jluehr-4711/tmp_crane/material/p3.jpeg

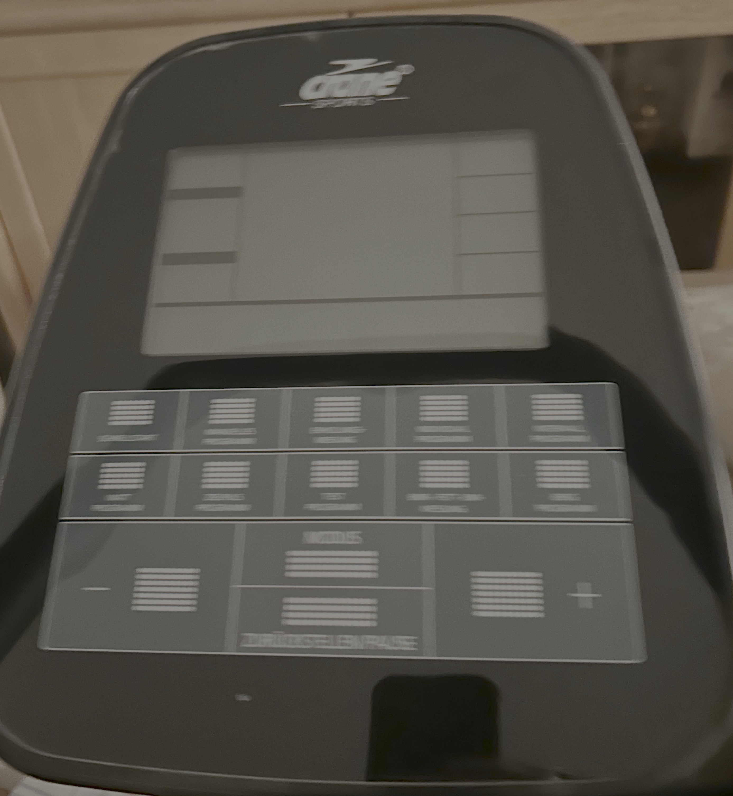
material/p3.jpeg
