jluehr-4711/tmp_crane/material/IMG_0629.jpeg

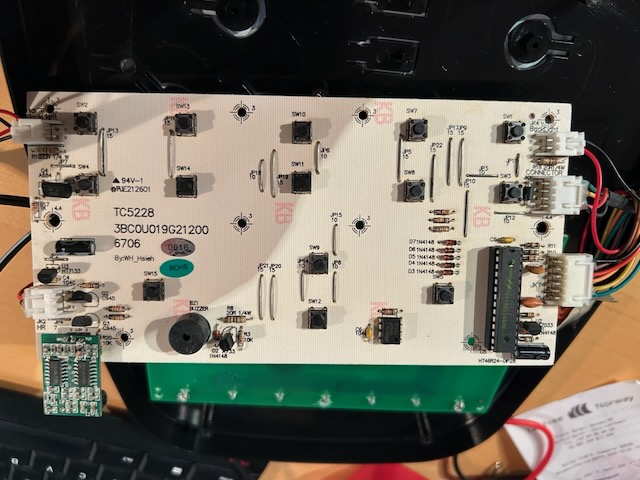
material/IMG_0629.jpeg
