jluehr-4711/tmp_crane/README.md

# tmp_crane

**Temporary data. Do not use.**

This repository is a temporary snapshot and may be changed or deleted at any time.
