jluehr-4711/tmp_crane/docs/README.md

# Project documentation index

Project: control a **Crane Sports Power X6 Crosstrainer-Ergometer** (Royalbeach Art.-Nr. 33821,
Aldi Süd 2006) with an ESP32, while keeping the original console swappable.

| Doc | Purpose |
|-----|---|
| [01-project-overview.md](01-project-overview.md) | Goal, rules, big picture, phases |
| [02-material-inventory.md](02-material-inventory.md) | Every file in `material/` and what it tells us |
| [03-hardware-reference.md](03-hardware-reference.md) | The machine: electrical system, parts, boards, connectors, known/unknown |
| [04-plan.md](04-plan.md) | Phased plan (wiring first, then software), next concrete steps |
| [05-open-questions.md](05-open-questions.md) | Questions for the owner + unknowns to measure |
| [06-photo-guide.md](06-photo-guide.md) | What to photograph before the measurement session, with plain-language locations |
| [07-sniffer.md](07-sniffer.md) | Sniffer firmware: pin map, dividers, parts list, usage |
| [08-prior-art.md](08-prior-art.md) | Existing projects (Reebok 5.7e etc.), what we reuse, what we must still measure |
| [09-shopping-list.md](09-shopping-list.md) | Parts with Reichelt article numbers and Amazon listings |
| [sessions/](sessions/) | One log per session, newest last |
| [reference/](reference/) | Extracted manual text (greppable) |
| [img/](img/) | Crops, rendered manual pages, and `adapter-schematic.svg` (KiCad schematic export) |
| [../hardware/kicad/](../hardware/kicad/) | KiCad schematic of the adapter board + generator script |
| [../hardware/perfboard/](../hardware/perfboard/) | Perfboard layout (validated against the schematic) + link table |
| [../firmware/](../firmware/) | ESP-IDF projects (sniffer) |

## Conventions

- Every session gets `sessions/YYYY-MM-DD-session-NN.md`: what was done, what was found, what is next.
- Measurements go into `03-hardware-reference.md` (facts) and the session log (how obtained).
- Part numbers in parentheses, e.g. "(91)", refer to the manual's spare-parts list (page 19).
- Unverified statements are marked **[assumption]**. Remove the tag once measured.
- Language: English, with original German terms in quotes where they help find things in the manual.
