jluehr-4711/tmp_crane/docs/sessions/2026-10-26-session-02.md

# Session 02 – 2026-10-26 – Repository, CLAUDE.md, sniffer firmware

## Plan step served
Phase 0 close-out (git, CLAUDE.md) and session 2 of the session plan (sniffer firmware, parts list).

## Done
- `git init`, first commit with docs and material. `.gitignore` for ESP-IDF build output.
- CLAUDE.md rewritten: typos fixed, decisions (interface point, ESP32 classic, AM33D, ESP-IDF, FTMS,
  plug swap, level + computed watts, English) recorded, docs pointers kept.
- ESP-IDF v5.5.6 installed under `~/esp/esp-idf`, toolchain under `~/.espressif`. The system has no
  `python3-venv`; the venv was created with `uv` and the requirements installed into it manually.
- `firmware/sniffer/`: ESP-IDF project, builds clean for the classic ESP32 (260 KB image).
  Modules: ADC probes (4 channels, calibrated), MCPWM capture of DOUT (80 MHz timestamps, frequency,
  duty, min/max), speed pulse timing (GPIO interrupt, 5 ms debounce), UART sniff, LEDC PWM output for
  the replay test, serial console with commands.
- `docs/07-sniffer.md`: pin map, dividers, probe harness and parts list, report format, session 4 procedure.

## Prior-art check (owner's question)
No documentation for this board/console exists online. dbsqp/bluetooth-reebok-57e is the closest analog
(5 V 1 kHz PWM brake, reed cadence, empirical watt model, ESP32 FTMS) and confirms the architecture; see
`08-prior-art.md`.

## Not done / limits
- The firmware is compiled but **not yet run on hardware**; a bench test with a known PWM (e.g. the
  ESP32's own GPIO27 output looped to GPIO25) is the first thing to do in session 3.

## Next
- Owner: order the parts in `07-sniffer.md`, flash the sniffer, loop GPIO27 → GPIO25 and check that
  `pwm 1000 25` is reported as 1000 Hz / 25 %.
- Session 3 at the machine: photos and multimeter identification (ground/speed wire), see `06-photo-guide.md`.
