jluehr-4711/tmp_crane/docs/img/adapter-perfboard.png

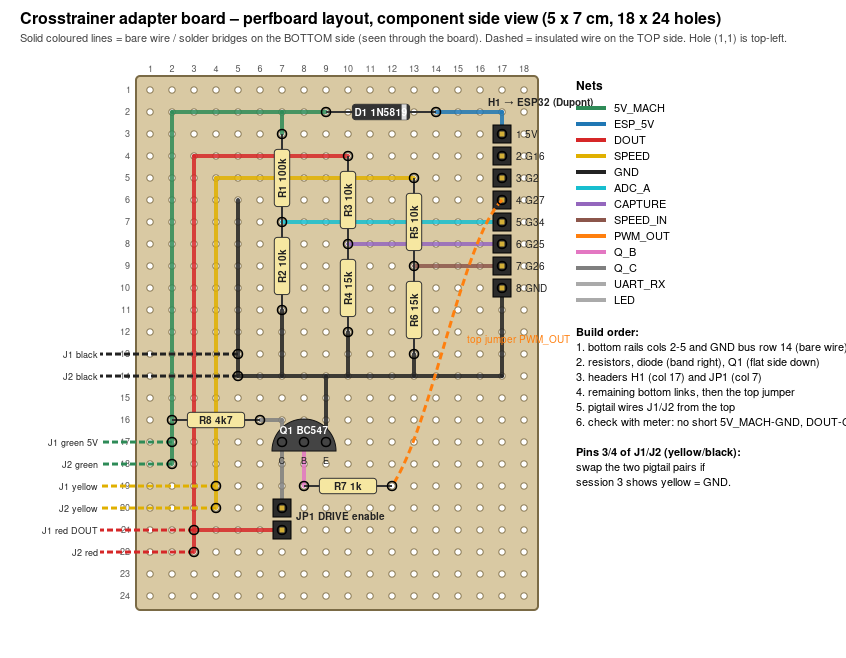
docs/img/adapter-perfboard.png
