jluehr-4711/tmp_crane/docs/img/adapter-schematic.png

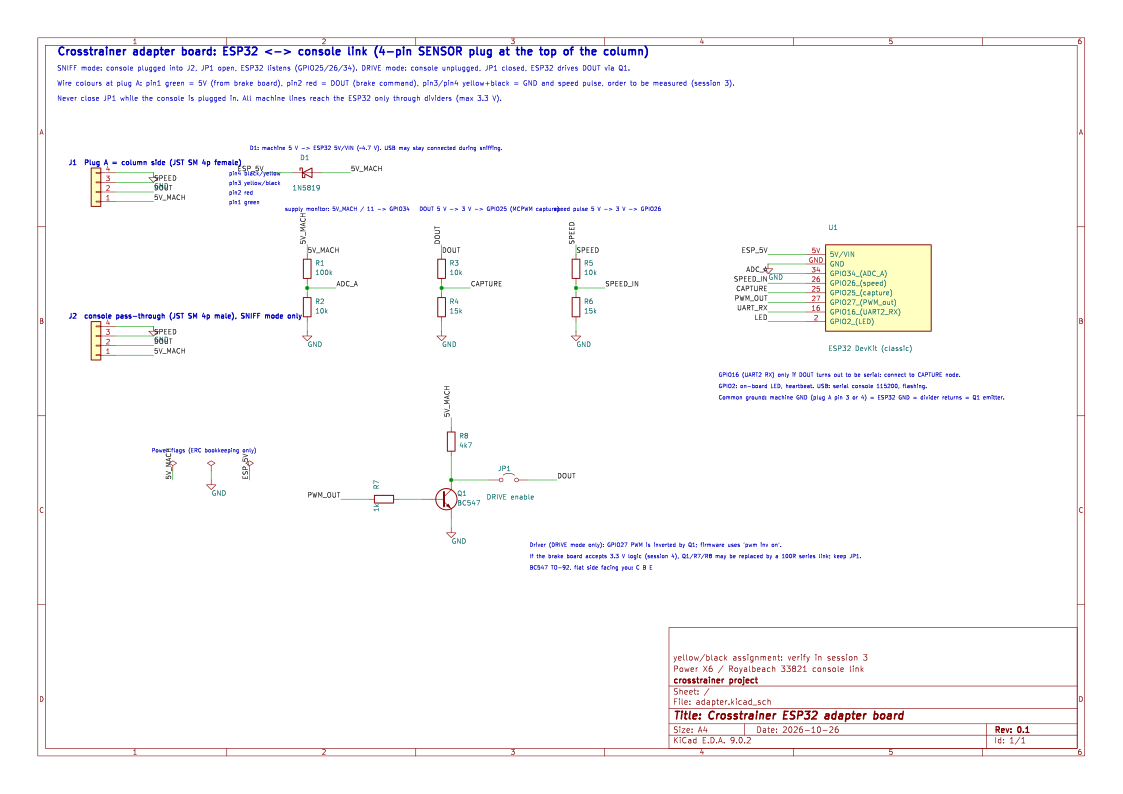
docs/img/adapter-schematic.png
