jluehr-4711/tmp_crane/docs/img/console-mainboard-label.png

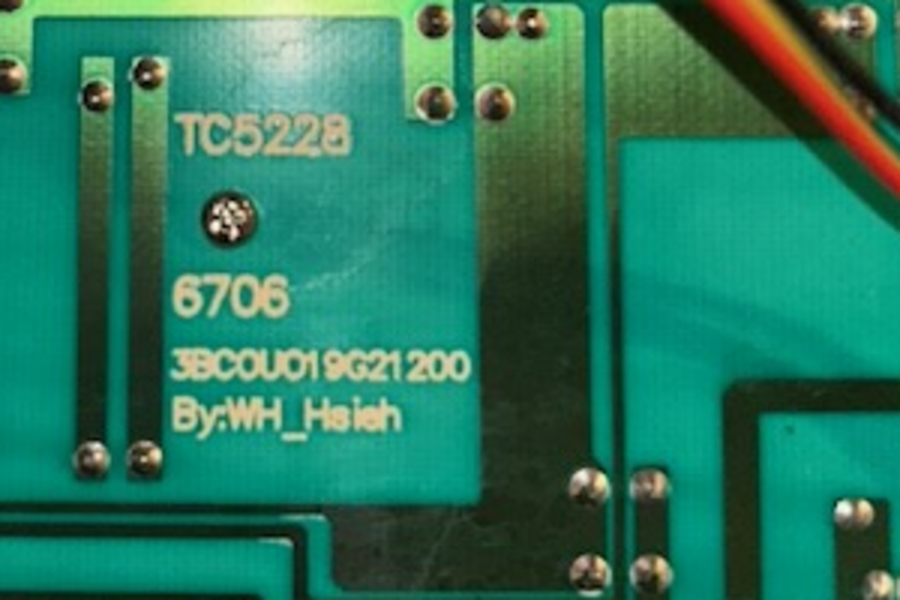
docs/img/console-mainboard-label.png
