jluehr-4711/tmp_crane/docs/img/console-pulse-daughterboard.png

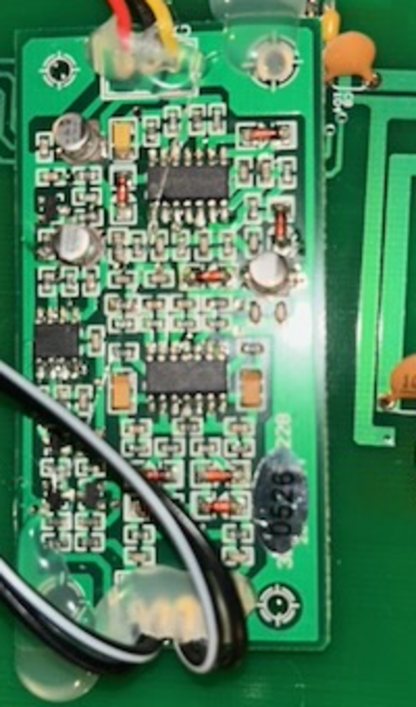
docs/img/console-pulse-daughterboard.png
