jluehr-4711/tmp_crane/docs/02-material-inventory.md

# 02 Material inventory (`material/`)

Reviewed 2026-10-26. Ten files, nine distinct (one duplicate). IMG_0629/0630 added later the same day from /tmp/r2.

| File | Type | What it is | Key facts extracted |
|---|---|---|---|
| `libble-eu_261836.pdf` | PDF, 20 pages A4 landscape, scanned/printed manual "ROY_AldS_BDA_PowerX6_Mont" dated 28.09.2006 | Assembly, operating and training manual for **Power X6 Crosstrainer-Ergometer, Art.-Nr. 33821** (Royalbeach for Aldi Süd) | Features, assembly incl. cable routing, power supply, troubleshooting, watt-measurement procedure, exploded view (p.18), spare-parts list (p.19). Text extracted to `reference/manual-33821-text.txt`. Note: the separate **console manual ("Bedienungsanleitung Computer")** mentioned in the scope of delivery is NOT included. |
| `IMG_0617.jpeg` | Photo 640x480, iPhone, 2026-10-26 18:23 | Label of the wall adapter (104) | **AC-AC ADAPTOR**, brand Yunyong / royalbeach, Model **AYY66-2602500**, Input 230 V~ 50 Hz 350 mA, **Output 26 V~ 2500 mA**, class II, thermal fuse 130 °C, CE/GS. |
| `IMG_0619.jpeg` | Photo 480x640, 2026-10-26 19:35 | Console opened: solder side of the console main PCB, with the small daughterboard at the top edge | Main PCB markings: **TC5228**, **6706**, "3BC0U019G21200 By:WH_Hsieh". A 3-wire lead (black / red / yellow) runs from the main PCB to the daughterboard. Daughterboard has an IR-style LED/receiver dome and a black twisted pair. |
| `IMG_0621.jpeg` | Photo 480x640, 2026-10-26 19:36 | Console opened: component side of the small daughterboard, mounted on the main PCB | Daughterboard marked **0526**; two SOIC-14/16 ICs, one SOT-23 transistor, electrolytics, many 0805 parts. Inputs: two black 2-wire cables (the hand-pulse sensor leads) and the 3-wire red/yellow/black lead to the main board. This is the **hand-pulse amplifier** **[assumption]**, which we do not need. A 100 nF ("104") cap and an SMD part sit next to it on the main board. |
| `p1.jpg` | Photo 1804x1212 | Type label on the console housing | **RB-33821-06605-B**, CE, WEEE symbol, ABS housing. "RB" = Royalbeach, 33821 = article. |
| `p2.jpg` | Photo 2417x1929 | Cable ends at the console / column | Two 2-pin latching connectors (JST SM style) labelled **"PULS"** (hand pulse, 2x), and one larger multi-pin connector labelled **"SEN…"** (cut off; most likely "SENSOR") with at least red and yellow wires visible. Pin count not readable. |
| `p3.jpeg` | Photo 2774x3013 | Console front, powered off | Crane Sports logo; segmented LCD with a large text field; **10 program keys** in two rows of 5; bottom row: **"–"**, a two-key block labelled **"MODE…"** (upper) and **"ZURÜCK / EINSTELLEN / PAUSE"** (lower, blurry), **"+"**. Matches manual: Schnellstart, manuell, HF-gesteuert, Fitnesstest, Typen-Training, Watt, Intervall, Bergfahrt, BMI/BMR/Körperfett, Erholungspuls. |
| `IMG_0629.jpeg` | Photo 640x480, 2026-10-26 20:12 | **Console main PCB, component side**, board out of the housing | Silkscreen readable: TC5228, 6706, 3BC0U019G21200, By:WH_Hsieh, 94V-1, RoHS. Connectors: **JK2 "HR"** 3-pin (to the pulse daughterboard), **JK5 "Backlight"** 3-pin (left), **JK4 "Backlight"** 3-pin (top right), **"CONNECTOR"** 4-pin (right, the cable to the tube; owner reads labels **"5V"** and **"DOUT"** next to it), **JK7** ~8-pin (lower right, multicolour ribbon to the LCD board). Parts: large DIP MCU = **HT46R24-DP28** (read by owner), 8-pin DIP near SW12 (unreadable, "KD363b?"), U2 **HT7133** (3.3 V LDO regulator) with C4 104, U7 **7033** (HT7033 voltage detector/reset) near the MCU, Q2/Q3 **C945** NPN, D1–D7 1N4148, R8/R9 **20 Ω 1/4 W**, buzzer BZ1, 15 tactile switches SW1–SW15, jumpers JP1–JP22. |
| `IMG_0630.jpeg` | Photo 640x480, 2026-10-26 20:13 | **Console main PCB, solder side, cable entry** | The black 4-wire sheathed cable from the tube ends in the 4-pin "CONNECTOR"; wire order at the connector, top to bottom in the photo: **green, yellow, red, black**. A separate multicolour ribbon (brown, red, orange, yellow, green…) goes into the larger white connector (JK7) and on to the LCD board. |
| `Ohne Titel 2.jpg` | duplicate | Byte-identical to `p3.jpeg` (same MD5) | Can be deleted. |

## What the material does NOT contain (needed later)
- Photos of the **brake control board (91)** inside the main frame and its connectors.
- The full pinout of the 4-pin SENSOR/"CONNECTOR" link: two of four labels known (5V, DOUT), two still to read.
- The console manual (button functions, how the 16 levels map to watts).
- Any schematic. Web search found nothing for this model or for Royalbeach brake boards.
