jluehr-4711/tmp_crane/docs/img/manual-p19-parts-list.png

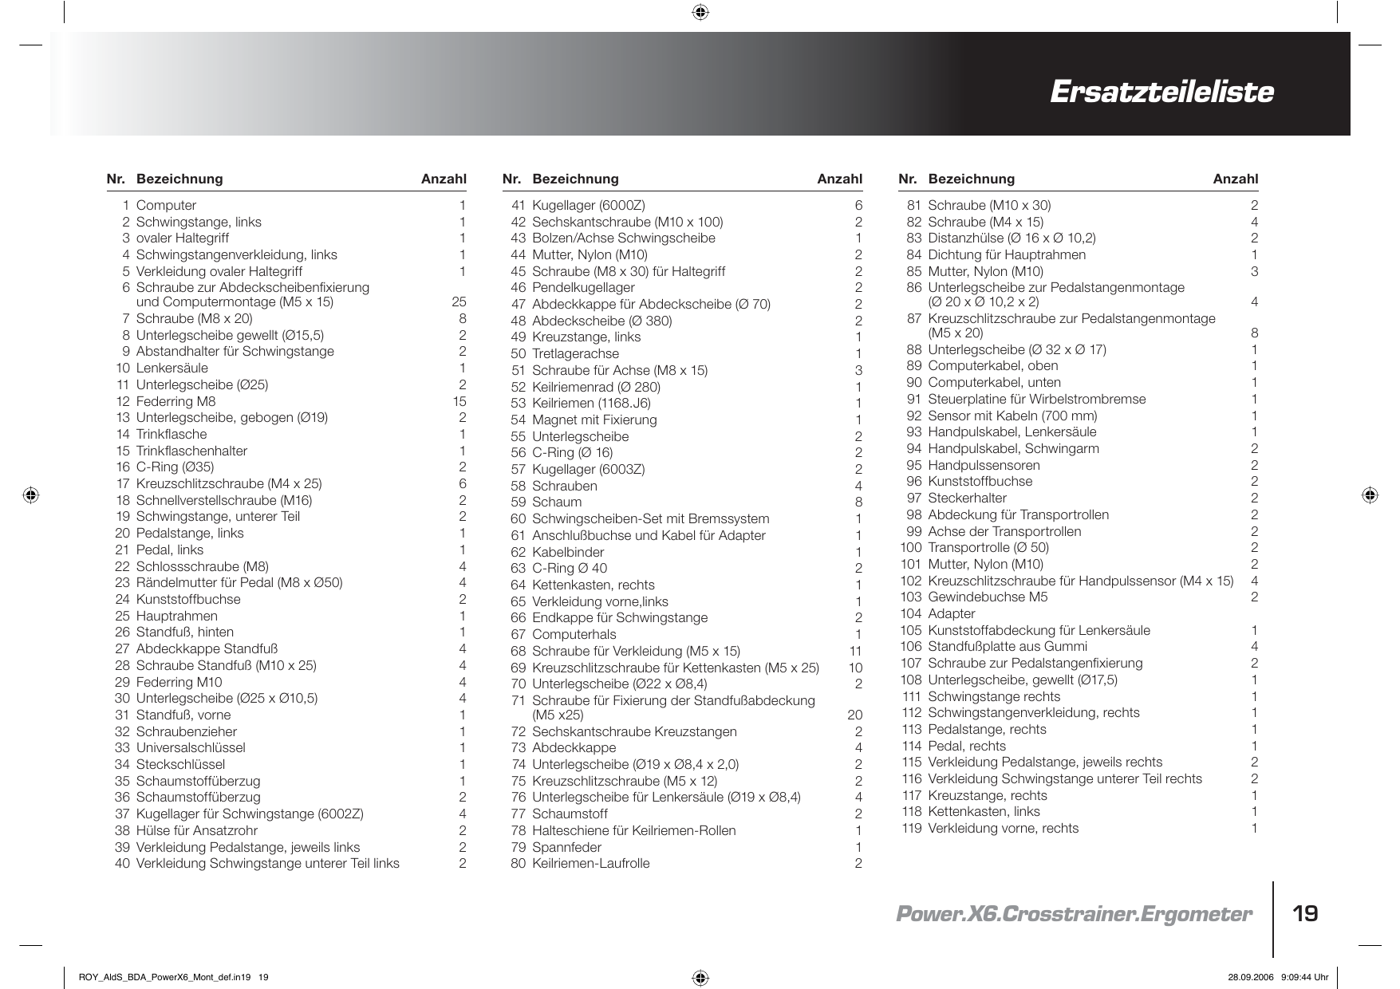
docs/img/manual-p19-parts-list.png
