jluehr-4711/tmp_crane/material/IMG_0617.jpeg

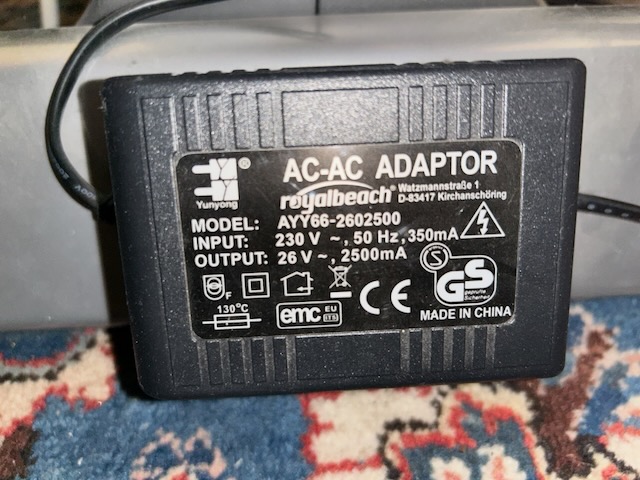
material/IMG_0617.jpeg
