jluehr-4711/tmp_crane/material/IMG_0619.jpeg

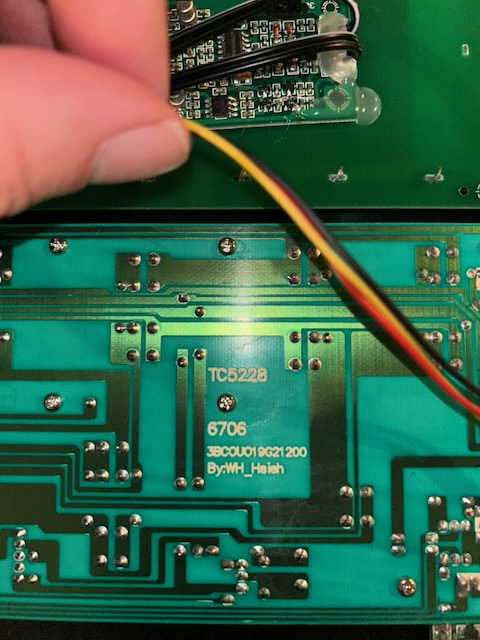
material/IMG_0619.jpeg
