jluehr-4711/tmp_crane/material/IMG_0621.jpeg

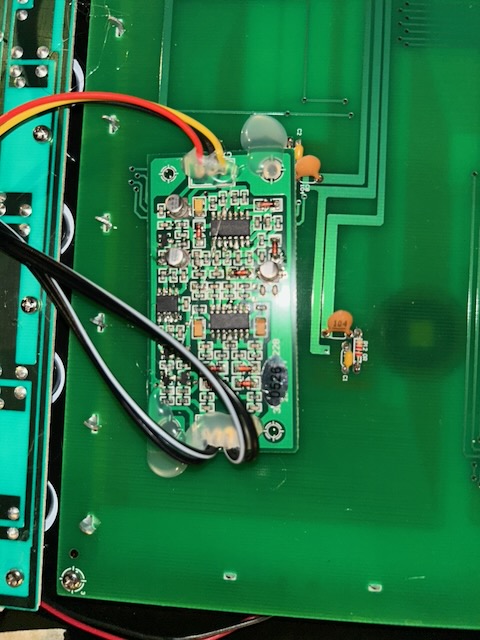
material/IMG_0621.jpeg
