jluehr-4711/tmp_crane/material/IMG_0630.jpeg

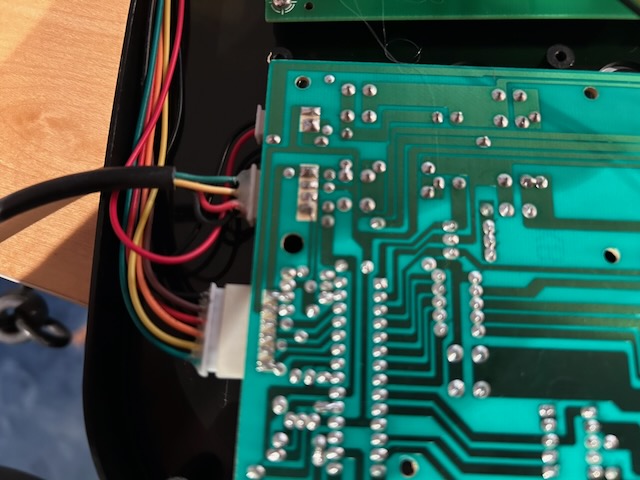
material/IMG_0630.jpeg
