jluehr-4711/tmp_crane/material/p1.jpg

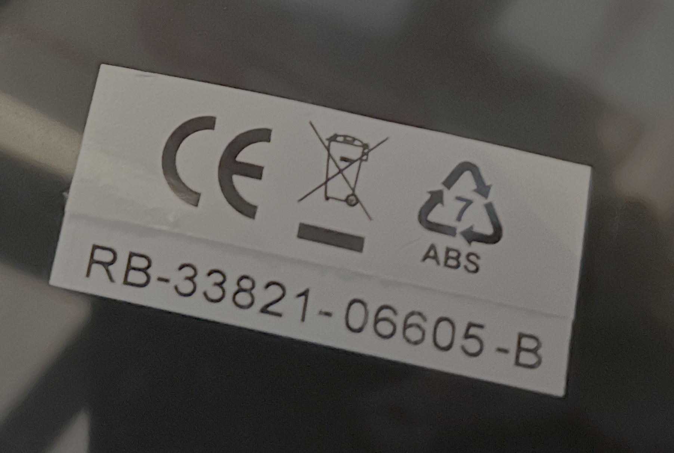
material/p1.jpg
