jluehr-4711/tmp_crane/material/p2.jpg

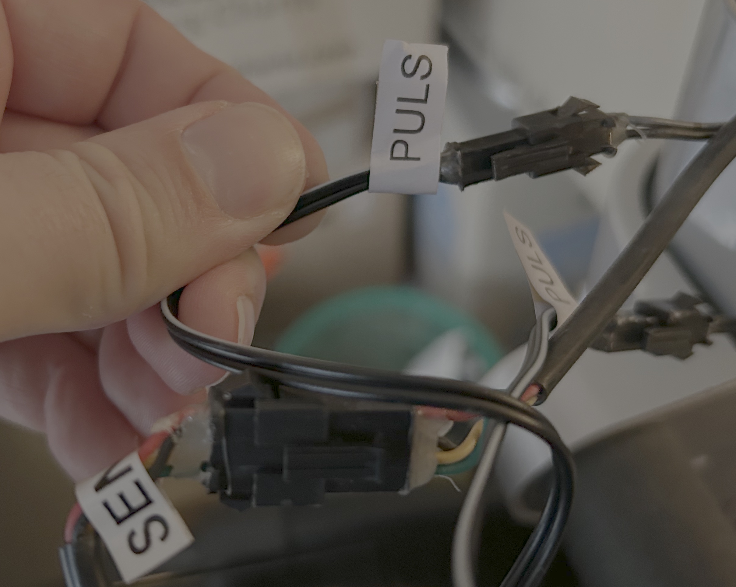
material/p2.jpg
