jluehr-4711/tmp_crane/docs/reference/manual-33821-text.txt

                                           Art.-Nr. 33821

              CROSSTRAINER
              ERGOMETER

             • Montageanleitung
             • Bedienungsanleitung
             • Trainingsanleitung

                                      Geprüft nach DIN EN
              I-4-2007                 957-1/9, Klasse HA

ROY_AldS_BDA_PowerX6_Mont_def.in1 1                         28.09.2006 9:09:15 Uhr

         Sicherheitshinweise / Verpackung / Entsorgung

                                                                          ➞ Falsches und übermäßiges Training kann Ihre                   Stromversorgung
           WICHTIG !
                                                                            Gesundheit gefährden.                                              ➞ Bevor der Stecker des Adapters an die Steckdose
           ➞ Vor der Inbetriebnahme des Gerätes machen Sie sich
                                                                          ➞ Die Montage-, Bedienungs- und Trainingsanleitung wird                 angeschlossen wird, muss die auf dem Adapter
             mit allen in dieser gedruckten Anleitung erwähnten
                                                                            auch zur Bestellung von Ersatzteilen benötigt.                        angegebene Netzspannung mit der örtlichen
             Montage-, Bedienungs-, Computer- und Trainings-
                                                                          ➞ Achten Sie darauf, dass keine Verstellvorrichtungen im                Netzspannung verglichen werden. Stimmen die
             sowie den Sicherheitshinweisen vertraut.
                                                                            Weg stehen, bevor Sie mit dem Training beginnen.                      Werte nicht überein, wenden Sie sich bitte an unser
           ➞ Die Sicherheitshinweise sind strikt zu befolgen.                                                                                     Serviceteam. Zur vollständigen Netztrennung ist der
           ➞ Die Anleitung sollte an einem sicheren Platz aufbewahrt            Dieses Trainingsgerät ist für Personen, die einen                 Netzstecker des Adapters aus der Steckdose zu
             werden.                                                            Herzschrittmacher oder andere medizinische                        ziehen. Das Gerät deshalb nur an leicht zugängliche
           ➞ Bei Weitergabe des Gerätes sind Montage-, Bedienungs-,             Implantate verwenden müssen, nicht geeignet!                      Steckdosen anschließen.
             Computer- und Trainingsanleitung beizulegen.                                                                                      ➞ Vor Anschluß des Adapter-Steckers an das Stromnetz
                                                                          ➞ Stellen Sie den Crosstrainer auf einen festen und ebenen
                                                                            Untergrund. Ein fester und sicherer Stand muss                        muss das Gerät vollständig aufgebaut sein!
           Sicherheitshinweise                                              gewährleistet sein.
                                                                                                                                          Trinkflasche
                                                                          ➞ Steigen Sie auf keine Teile des Gerätes außer den
                                                                                                                                                 ➞ Bitte halten Sie die Trinkflasche aufgrund des ablös-
         Der Anwendungsbereich dieses Trainingsgerätes ist der              Trittflächen.
                                                                                                                                                    baren Verschlusses von Kleinkindern und Babys fern
         Heimbereich. Das Gerät entspricht den Anforderungen              ➞ Es liegt in der Verantwortung des Besitzers, alle anderen               (Verschluckungsgefahr)!
         DIN EN 957-1/9 Klasse HA und ist GS-geprüft.                       Personen, die das Gerät benutzen, ausreichend über
                                                                                                                                                 ➞ Bitte beachten Sie, dass das Mundstück der
         Das Gerät ist nach dieser Norm für ein Körpergewicht von           etwaige Gefahren zu informieren.
                                                                                                                                                    Trinkflasche zu Reinigungszwecken vom Verschluss
         150 kg Dauerbelastung geprüft worden. Die CE-Kennzeichnung       ➞ Das Gerät ist ausschließlich für den Heimgebrauch gedacht               abgenommen werden kann und sich deshalb ab einer
         bezieht sich auf die elektromagnetische Verträglichkeit EMV        und darf nur in geschlossenen Räumen (nicht im Freien)                  bestimmten Zugkraft löst.
         (EG-Richtlinie 89/336/EWG und EN 55081-1). Bei unsachge-           benutzt werden.
         mäßem Gebrauch dieses Gerätes (z. B. übermäßiges Training,       ➞ Kinder sollten nur mit entsprechender geistiger und körper-
         ruckartige Bewegungen ohne vorheriges Aufwärmen, falsche           licher Entwicklung am Gerät trainieren und auf die richtige    Verpackung
         Einstellungen etc.) sind Gesundheitsschäden nicht auszuschlie-     Benutzung hingewiesen werden.
         ßen! Vor Beginn des Trainings sollte ein allgemeiner Fitness-                                                                    Umweltfreundliche, wiederverwertbare Materialien:
                                                                          ➞ Nicht geeignet für körperlich oder geistig behinderte         ➞ Außenverpackung aus Pappe
         Check von Ihrem Arzt durchgeführt und eventuelle Herz-,            Personen.
         Kreislauf- oder orthopädische Probleme abgeklärt werden.                                                                         ➞ Formteile aus geschäumtem, FCKW-freiem Polystyrol (PS)
                                                                          ➞ Trainingsgeräte sind auf keinen Fall als Spielgeräte          ➞ Folien und Beutel aus Polyäthylen (PE)
                                                                            geeignet. Unbeaufsichtigte Kinder vom Gerät fernhalten!       ➞ Spannbänder aus Polypropylen (PP)
         BITTE BEACHTEN SIE:                                              ➞ Benutzen Sie eine Unterlegmatte, auf der Sie das              ➞ Plastiktüten der Verpackung müssen von Kindern
         ➞ Dieses Gerät ist ein drehzahlunabhängiges Trainingsgerät         Gerät aufstellen, um den Boden nicht zu beschädigen.            ferngehalten werden.
            der Klasse HA.                                                ➞ Transportieren Sie das Gerät niemals alleine über Stiegen
         ➞ Das Bremssystem ist geschwindigkeitsunabhängig.                  oder andere Hindernisse.
         ➞ Stoppen Sie das Gerät niemals abrupt ab, sondern lassen        ➞ Auf keinen Fall die Augen während der Benutzung schließen.     Entsorgung
            Sie es langsam auslaufen.                                     ➞ Sollten Sie das Gerät demontieren wollen, gehen Sie in der    Bitte achten Sie auf eine umweltgerechte Entsorgung der
         ➞ Ihr Computer stoppt automatisch, wenn die Pedale                 umgekehrten Reihenfolge des in der Anleitung beschriebenen    Verpackung nach lokalen Vorschriften!
            nicht mehr betätigt werden.                                     Zusammenbaus vor. Bei Unklarheiten kontaktieren Sie bitte                 Entsorgung des Altgerätes: Beachten Sie beim
         ➞ Der Tretwiderstand kann über die Computertasten                  vorab unser Serviceteam.                                                  Entsorgen des Gerätes die örtlichen Entsorgungs-
            (+/-) reguliert werden.                                       ➞ Das Gerät nur wie in der Anleitung beschrieben benutzen.                  vorschriften. In Deutschland fällt dieses Gerät unter
         ➞ Der Tretwiderstand (Belastung) wird in Watt am                 ➞ Es ist sicher zu stellen, das unbeaufsichtigte Kinder vom                 die Elektroschrottverordnung und muss im Falle
             Computerdisplay angezeigt.                                     Trainingsgerät ferngehalten werden.                                       einer Entsorgung an einer der kommunalen Sammel-
                                                                                                                                                      stellen innerhalb von Deutschland entsorgt bzw.
                                                                                                                                                      abgegeben werden. Diese Entsorgung ist kostenlos.

 2           Power.X6.Crosstrainer.Ergometer

ROY_AldS_BDA_PowerX6_Mont_def.in2 2                                                                                                                                                            28.09.2006 9:09:29 Uhr

                               Symbol-Erklärung                       Inhalt
                                                                     Das Trainingsgerät
                                                                     Kleinteile/Blisterkarte . . . . . . . . . . . . . . . . . . . . . . . . . . . . . . . . . . . 4
                                                                     Ausstattung/Lieferumfang/Hotline . . . . . . . . . . . . . . . . . . . . . . . . . . 5

                                                                     Die 9-Schritte-Montage
                                         HINWEIS                     1. Überprüfen des Lieferumfanges . . . . . . . . . . . . . . . . . . . . . . . . . 6
                                 Macht Sie beim Lesen der            2. Montage des vorderen und hinteren Standfußes. . . . . . . . . . . . . . . 7
                              Bedienungsanleitung auf wichtige
                          Informationen und Hinweise aufmerksam.     3. Montage der Lenkersäule . . . . . . . . . . . . . . . . . . . . . . . . . . . . . . 8
                                                                     4. Montage des Computers. . . . . . . . . . . . . . . . . . . . . . . . . . . . . . . 9
                                                                     5. Montage des Trinkflaschenhalters. . . . . . . . . . . . . . . . . . . . . . . . 10
                                                                     6. Montage des ovalen Haltegriffes . . . . . . . . . . . . . . . . . . . . . . . . 10
                                                                     7. Montage der Schwingstangen . . . . . . . . . . . . . . . . . . . . . . . . . . 11
                                                                     8. Montage der Pedale . . . . . . . . . . . . . . . . . . . . . . . . . . . . . . . . . 12
                                                                     9. Stromversorgung und Endkontrolle . . . . . . . . . . . . . . . . . . . . . . . 13

                                                                     Trainingshinweise . . . . . . . . . . . . . . . . . . . . . . . . . . . . . 14/15
                                          ACHTUNG
                                  Enthält wichtige Hinweise          Was Sie sonst noch wissen sollten
                                zur Vermeidung von Schäden
                                                                     Richtiges Auf- und Absteigen . . . . . . . . . . . . . . . . . . . . . . . . . . . . . 15
                                          am Gerät.
                                                                     Crosstrainer Trainingstechnik . . . . . . . . . . . . . . . . . . . . . . . . . . . . . 15
                                                                     Pflege und Wartung . . . . . . . . . . . . . . . . . . . . . . . . . . . . . . . . . . . 16
                                                                     Fehlersuche . . . . . . . . . . . . . . . . . . . . . . . . . . . . . . . . . . . . . . . . . 16
                                                                     Transport und Bewegung des Gerätes . . . . . . . . . . . . . . . . . . . . . . . 16

                                                                     Garantie, Service, Hotline. . . . . . . . . . . . . . . . . . . . . . . . . 17
                                                                     Widerstandsmessung (Watt-Messung) . . . . . . . . . . . . . . . . . . . . . . 17

                                         WARNUNG                     Ersatzteileliste (inkl. Explosionszeichnung) . . . . . . 18/19
                          Enthält wichtige Hinweise zur Vermeidung
                            von Personenschäden (Verletzungen).      HINWEIS: Satzfehler und Änderungen vorbehalten!

                                                                                                           Power.X6.Crosstrainer.Ergometer                                             3

ROY_AldS_BDA_PowerX6_Mont_def.in3 3                                                                                                                                     28.09.2006 9:09:30 Uhr

         Kleinteile

           Kleinteile/Blisterkarte
         Auf dieser Seite finden Sie alle Kleinteile
                                                           Power X6 Crosstrainer-Ergometer
         (Schrauben, Unterlegscheiben, Muttern und
         Werkzeuge) abgebildet, welche Sie zur
         Montage des Gerätes benötigen.
         Alle diese Teile liegen auf einer Blisterkarte
         eingeschweißt der Kartonverpackung bei.

                                                                                  Universalschlüssel (33) 1 Stk.

                                                              Steckschlüssel (34) 1 Stk.
                                                                                                     Federring M10 (29) 4 Stk.

                                                          Sechskantschraube M10 (28) 4 Stk.
                                                                                                   Unterlegscheibe (30) 4 Stk.

                                                                                               Schraubenzieher (32) 1 Stk.

 4           Power.X6.Crosstrainer.Ergometer

ROY_AldS_BDA_PowerX6_Mont_def.in4 4                                                                                              28.09.2006 9:09:30 Uhr

                                                                                                                                                                      Ausstattung

       Power X6 Crosstrainer-Ergometer – Ausstattungsmerkmale
       Beleuchteter EASY-CONTROL-Trainingscomputer                  Große Haltereling                                                                      Beleuchteter EASY-CONTROL-
                                                                                                                                                           Trainingsomputer mit integrierter
       • integrierte Hilfefunktion-Menüführung                      Hochwertige elektromagnetische                                                         Hilfefunktion-Menüführung
         extragroßes Textfeld informiert über den                   Wirbelstrombremse (Induktionsbremse)
         nächsten Bedienschritt                                     extrem leistungsfähig bis 400 Watt
       • große, übersichtliche Computertasten
                                                                    Widerstand in 16 Stufen
       • ein Knopfdruck und Programm ist gewählt
                                                                    über den Computer steuerbar                                                   Pulsmessung
       • blau hinterleuchtete LCD-Anzeige
       • LCD-Anzeige in deutscher Sprache                           stabile Stahlkonstruktion                                                    erfolgt über Mega-
                                                                                                                                                Handkontakt-
       Funktionen:                                                                                                                                                             Gewicht:
                                                                    inkl. Trinkflasche mit Maßangabe                                         Sensoren an den
       Strecke in km, Zeit, Geschwindigkeit, Watt, Puls,                                                                                                                       ca. 59 kg
                                                                    und Trinkflaschenhalter                                                  Schwingstangen oder
       Umdrehungen pro Minute, Ca. Energieverbrauch in Kilojoule,                                                                            über Pulsempfänger
       BMI (Body-Mass-Index), BMR (Basal Metabolic Rate),                                                                                                                      Max.
                                                                                                                                             (Sendebrustgurt nicht
       Fitnessnote/Erholungspulsmessung, Körperfett                 verstellbare, rutschfeste                                                                                  Belastbarkeit:
                                                                                                                                             im Lieferumfang)
                                                                    Trittfläche                                                                                                150 kg
       Programme:
       • Schnellstart-Programm                                                                                                               Pedalstangen              Aufstellmaße
                                                                    Keilriemenantrieb                                                        höhenverstellbar
       • manuelles Programm                                         für besonders leisen                                                                               in cm:
       • herzfrequenzgesteuertes Programm                           und gleichmäßigen
       • persönliches Fitnesstest-Programm                                                                                                   Transportrollen
                                                                    Rundlauf

                                                                                                                                                                                                  164
       • individuelles Typen-Trainingsprogramm
       • wattgesteuertes Trainingsprogramm
         (drehzahlunabhängig)                                       Schwungscheibe                                                           integrierter,
       • Intervall-Programm mit wählbarer Intensitätsstufe          ca. 8 kg                                                                 automatischer
       • Bergfahrt-Programm mit wählbarer Intensitätsstufe                                                                                   Bodenniveau-
       • BMI-, BMR-, Körperfett-Messprogramm                        Stromversorgung                                                          Ausgleich                 69           158
                                                                    über Netzadapter

                                                                    Trainingsplanungs- und Trainingsauswertungs-Software:
       Hotline                                                      Beratungen und Informationen zu den auf der DVD befind-            Lieferumfang
                                                                    lichen Trainingsplanungs- und Trainingsauswertungs-Software
     Service                                                        sind ausschließlich unter folgender kostenpflichtiger Nummer      ➞ Einzelteile entsprechend der Teileliste
     Für technische Auskünfte und Beratung zu diesem Gerät steht    möglich:                                                          ➞ Montagewerkzeug
     Ihnen unsere Service-Hotline unter folgender Nummer zur        ➞ Telefon: 0180 / 50 20 307 (! 0,12 / Min.)                       ➞ Montage-, Bedienungs- und Trainingsanleitung
     Verfügung. RC Sportgeräte Service                              ➞ E-Mail: service@rc-sportgeraete.de
     ➞ Telefon: 0800/020 30 45 (kostenlos)                                                                                            ➞ DVD
                                                                            Bitte beachten Sie: Aus rechtlichen Gründen ist seitens   ➞ Bedienungsanleitung Computer
     ➞ E-Mail: service @ rc-sportgeraete.de                                 der Hotline keine Trainingsberatung möglich und es
            Bitte beachten Sie: Unter dieser Hotline wird keine             werden keine gesundheitlichen Ratschläge erteilt.
            Beratung zur Trainingsplanungs- und Traininigs-
            auswertungs-Software angeboten.                         Ersatzteilbestellung: Genaue Gerätebezeichnung und Be-
                                                                    stellnummer unbedingt angeben!
                                                                    Gerätebezeichnung:       Power X6 Crosstrainer-Ergometer
                                                                    Art.-Nr.:                33821
                                                                                                                                      Power.X6.Crosstrainer.Ergometer                                         5

ROY_AldS_BDA_PowerX6_Mont_def.in5 5                                                                                                                                                            28.09.2006 9:09:30 Uhr

         Montage

           1. Überprüfen des Lieferumfanges
         ➞ Packen Sie alle Einzelteile sorgfältig aus und legen Sie diese
           nebeneinander auf den Boden.                                                                                             Hauptrahmen (25)
           Um ein Zerkratzen des Bodens zu vermeiden, benutzen Sie
           eine geeignete Unterlage.
         ➞ Stellen Sie den Hauptrahmen auf eine flache Unterlage und
           achten Sie auf einen stabilen Stand.
         ➞ Achten Sie darauf, dass Sie beim Zusammenbau in jede
           Richtung hin genügend Bewegungsfreiraum (mind. 1,5 m)
           haben.
                                                                            Standfuß, hinten (26)
         ➞ Bevor Sie mit der Montage beginnen, machen Sie sich
                                                                                                                                                                                  Standfuß,
           nochmals mit allen abgebildeten Einzelteilen vertraut.
                                                                                                                              Pedale (21, 114)                                    vorne (31)

                                                                                                                                                                                       Trinkflasche (14)

                                                                                                                                                                                ovaler Haltegriff (3)
                                                                            Netzadapter (104)

                                                                                                                                                                                               Verkleidung ova-
                                                                                                                                                                                               ler Haltegriff (5)
                                                                                                    Schwingstangen (2, 111)
                                                                                                                                          Computer (1)

                                                                                                                                                                      Power X6 Crosstrainer-Ergometer

                                                                                                                                                         Lenker-                                   Universalschlüssel (33) 1 Stk.

                                                                                                                                                         säule (10)            Steckschlüssel (34) 1 Stk.
                                                                                                                                                                                                                      Federring M10 (29) 4 Stk.

                                                                                                                                                                           Sechskantschraube M10 (28) 4 Stk.
                                                                                                                                                                                                                    Unterlegscheibe (30) 4 Stk.

                                                                                                                                                                                                                Schraubenzieher (32) 1 Stk.

                                                                                                                                                                      Blisterkarte

 6           Power.X6.Crosstrainer.Ergometer

ROY_AldS_BDA_PowerX6_Mont_def.in6 6                                                                                                                                                                                        28.09.2006 9:09:32 Uhr

                                                                                                                                     Montage

       2. Montage des vorderen und hinteren Standfußes

        1                                           2                                         3         (25)

                               (25)
                                                                                                                              (26)

                                                               (28)

                                                                               (29), (30)
                                             (31)

                                                        (28)
            (26)

                                                                      (29), (30)

                                                                                            Bild 1: Ausgangsposition
        4                                           5
                                                                                            Bild 2–4: Nehmen Sie jeweils den Standfuß (26, 31)
                                                                                            und fixieren Sie ihn mit je zwei Unterlegscheiben (30),
                                                                                            zwei Federringen (29) und zwei Schrauben (28) mit Hilfe
                                                                                            des Universalschlüssels (33) am Hauptrahmen (25).
                                                                                            Bild 5: Zielposition

                                                                                                   Achten Sie darauf, dass die Transportrollen
                                                                                                   zum Boden schauen!
                                      (31)                                                         Die beiden elastischen Standfuß-Endkappen
                                                                                                   gewährleisten den automatischen Ausgleich
                                                                                                   von leichten Bodenunebenheiten!
            (25)
                                                                                                   Bei diesem Montageschritt bedarf es
                                                                                                   der Zuhilfenahme einer zweiten Person,
                                                                                                   die das Gerät sicher hält.

                                                                                            Power.X6.Crosstrainer.Ergometer                                          7

ROY_AldS_BDA_PowerX6_Mont_def.in7 7                                                                                                                   28.09.2006 9:09:32 Uhr

         Montage

           3. Montage der Lenkersäule
                                                                                                             Bild 1: Ausgangsposition
            1               (25)                2                                3
                                                                                                             Bild 2: Schrauben Sie die sechs vor-
                                                                                                             montierten Schrauben (7) mit den sechs
                                                                                                             Federringen (12) und den sechs Unterleg-
                                                    (7, 12, 76)   (13)                                       scheiben (76+13) aus dem Hauptrahmen (25)
                                                                                                     (105)   heraus.
                                                                                                             Bild 3+4: Jetzt schieben Sie die Verkleid-
                                                                                                             ung (105) vorsichtig auf die Lenkersäule (10),
                                       (10)                                                   (10)           führen diese nahe an den Hauptrahmen (25)
          (105)                                                      (25)
                                                                                                             heran und verbinden die beiden Computer-
                                                                                                             kabel (89/90) miteinander.
                                                                                                             Bild 5: Stecken Sie die Lenkersäule (10)
            4                                   5                   (10)         6                           vorsichtig auf den Hauptrahmen (25), achten
                                         (10)                                                                Sie darauf, dass keine Kabel überstehen.
                                                                                                             Bild 6+7: Anschließend fixieren Sie die Säule
                                      (89)                                      (7, 12, 76)
                                                                                                             mit den sechs Schrauben (7), den sechs Feder-
                                                                                                             ringen (12) und den sechs Unterlegscheiben
                                       (90)                                                                  (76+13) und bringen die Verkleidung (105) in
                                                                                                             die Endposition.

                                                                         (25)
                                                                                                             Bild 8: Zielposition
                                        (25)
                                                                                                                     1. Achten Sie darauf, dass
                                                                                                                        Schrauben mit der gewölbten
            7                          (10)
                                                8                                                                       Unterlegscheibe aus technischen
                                                                                                                        Gründen prinzipiell als erstes
                                                                                                                        angezogen werden müssen.
                                      (105)
                                                                                                                     2. Achten Sie auf eine ordentliche
                                                                                                                        und feste Kabelverbindung,
                                                                                                                        da ansonsten keine Signal-
                                                                                                                        übertragung zum Computer
                                                                                                                        erfolgt. Die Kabelverbindung
                                      (25)                                                                              muss sich an der Rahmen-
                                                                                                                        innenseite befinden und darf
                                                                                                                        nicht darüber hinaus stehen,
                                                                                                                        da ansonsten die Kabel beim
                                                                                                                        Einschieben beschädigt werden
                                                                                                                        könnten.

 8           Power.X6.Crosstrainer.Ergometer

ROY_AldS_BDA_PowerX6_Mont_def.in8 8                                                                                                              28.09.2006 9:09:34 Uhr

                                                                                                                                                                       Montage

       4. Montage des Computers
     Bild 1: Ausgangsposition
                                                       1                                            2                                            3
     Bild 2: Schrauben Sie zunächst die drei                                                                  (6)                                                           (1)
     vormontierten Schrauben (6) aus der
     Lenkersäule (10) heraus.
                                                                   (25)                                     (6)
     Bild 3: Den bereits vorverkabelten Compu-
     ter (1) verbinden Sie jetzt mit der Säule (10),                                                                           (6)                              (89)
     indem Sie den Klinkenstecker (89) mit seinem
     Gegenstück verbinden. Achten Sie auf eine
     feste Kabelverbindung.                                                                                                 (10)
                                                                                (1)                                                                      (10)
     Bild 4+5: Stecken Sie den Computer (1) auf
     die Lenkersäule (10) und fixieren ihn mit den
     drei Schrauben (6).
                                                       4                                            5                                            6
     Bild 6: Zielposition
                                                                  (1)
             Die Computerkabel (89+90) dienen                                                         (6)                    (1)
             der Steuerung des Widerstandes
             und der Übermittlung von Funktions-                                                     (6)
             werten, wie z. B. Geschwindigkeit                                                                                (6)
             oder Trittfrequenz, an den Computer.

                                                           (10)                                             (10)

              • Achten Sie auf eine ordentliche und feste Kabelverbindung, da ansonsten keine Signalübertragung an den Computer erfolgt. Die Kabelverbindung muss sich an der
                Rahmeninnenseite befinden und darf nicht darüber hinaus stehen, da ansonsten die Kabel beim Einschieben bechädigt werden können.
              • Ein zu festes Anziehen der Schrauben kann zum Bruch des Kunststoffes führen.

                                                                                                                                   Power.X6.Crosstrainer.Ergometer                               9

ROY_AldS_BDA_PowerX6_Mont_def.in9 9                                                                                                                                               28.09.2006 9:09:35 Uhr

         Montage

           5. Montage des Trinkflaschenhalters                                                                 1                         2                 3                 4
                                                                                                                                        (6)                     (15)
          Bild 1: Ausgangsposition
                                                                                                                                                          (6)
          Bild 2+3: Schrauben Sie die zwei vormontierten Schrauben (6) aus der Lenkersäule (10)
          heraus und fixieren Sie den Trinkflaschenhalter (15) an dieser Stelle.
          Bild 4: Stecken Sie die Trinkflasche (14) in den Halter.                                                                                        (6)
                                                                                                                                              (6)
                   Achten Sie während des Trainings darauf, immer genügend Flüssigkeit zu
                   sich zu nehmen.                                                                                                                                           (14)

           6. Montage des ovalen Haltegriffes

            1                                                   2                                              3                                            4
                                                                         (3)
                                                                                       (10)

                                                                     (45, 12, 74)                                                                           (3)
                                                                                                                                                                       (5)    (45, 12, 74)
                                                                                                                                                    (5)
                                                                                                              (3)                (10)                                         (10)

         Bild 1: Ausgangsposition                                                                                                                           5
         Bild 2–4: Schrauben Sie die beiden vormontierten Schrauben (45), die beiden Federringe (12) und die beiden Unterlegscheiben (74) aus dem
         Haltegriff (3) heraus. Führen Sie nun den Haltegriff (3) an die Metallschiene und fixieren sie mit den Schrauben die Kunststoffabdeckung (5)
         an der Lenkersäule (10).
         Bild 5: Zielposition

10           Power.X6.Crosstrainer.Ergometer

ROY_AldS_BDA_PowerX6_Mont_def.in10 10                                                                                                                                                28.09.2006 9:09:36 Uhr

                                                                                                                                                         Montage

       7. Montage der Schwingstangen
                                                                                                                                  Bild 1: Ausgangsposition
        1                                                 2     (7, 12, 11)   (10)            3        (10)
                                                                                                                                  Bild 2: Schrauben Sie die beiden vor-
                                                                                                                        (111)     montierten Schrauben (7), die beiden Feder-
                                                                                                                                  ringe (12) und die beiden Unterlegscheiben
                                                                                (11, 12, 7)                                       (11) aus der Lenkersäulenachse (10) heraus.
                                                                                                                                  Bild 3+4: Nun stecken Sie die rechte
                                                                                                                                  Schwingstange (111) an die rechte Achse der
                                                                                                                                  Lenkersäule (10) und befestigen diese mit
                                                (2/111)
                                                                                                                                  der Schraube (7), dem Federring (12) und der
                                                                                                                                  Unterlegscheibe (11) und stecken die
                                                                                                                                  Abdeckkappe (73) darauf.
                                                                                                                                  Bild 5: Ebenso wird die linke Schwing-
        4                                                 5                          (111)    6        (2/111)                    stange (2) montiert.
                                                                                                                                  Bild 6: Verbinden Sie die oberen mit den
                                                                                                         1.                       unteren Pedalstangen und fixieren diese mit
                                 (111)
                                                                                                  2.                              der Schnellverstellschraube.
                                                          (2)                                                             3.      Bild 7: Sobald die Schnellverstellschraube
                                   (11, 12, 7)                                                                                    einrastet, drehen Sie diese fest.
                                         (73)                                                                                            Mit den Schnellverstellschrauben
                                                                                                                                         verstellen Sie den Winkel der
                                                                                                              (18/19)                    Pedalstangen.
                                                                                                                                         Je steiler der Winkel, desto
                                                                                                                                         mehr Belastung wirkt auf Ihre
        7                                                 8                                   9                                          Beinmuskulatur.

                                                                                                                                  Bild 8: Nun stecken Sie die Kabel der beiden
                                                                                                                                  Handpulssensoren in die Einsteckbuchse an
                                                                                                                                  der Lenkersäule.
                                                              (94)
                                                                                                                                         Achten Sie auf eine ordentliche
                 (18)
                                                                                                                                         und feste Steckerverbindung, da
                                                                                                                                         ansonsten keine Signalüber-
                                                                                                                                         tragung zum Computer erfolgt.

                                                                                                                                  Bild 9: Zielposition

                                                                                                                          Power.X6.Crosstrainer.Ergometer                               11

ROY_AldS_BDA_PowerX6_Mont_def.in11 11                                                                                                                                      28.09.2006 9:09:38 Uhr

         Montage

           8. Montage der Pedale

            1                                                 2                                                   3                                               4

                                                                           (22)
                                                                                                                                             1.
                                                                                             (22)                                                                            (22)
                                                                                                    (20)                     (114)

                                                                                                                                                                                           (22)
                                                                                   (113)
                                                                                                                                     (113)
                                                                                                    (23)
                                                                                                                                                                      (23)
                                                                    (23)
                                                                                                                                                         2.
                                                                                                                                                  (23)
                                                                                                                             2.                                                            (23)
                                                                                                                      (23)
                                                             (25)
                                                                                                                                                                                    (20)

                             (114)

                                            (21)

         Bild 1: Ausgangsposition
                                                                                                                                                                  5
         Bild 2+3: Lösen Sie die an den Pedalstangen (20, 113) vormontierten Rändelmuttern (23) und Schrauben (22) und fixieren Sie damit die Pedale (21, 114).
         Bild 4: Mit Hilfe der Rändelmuttern (23) an der Pedalunterseite können Sie die Pedale in die richtige Position bringen.
         Bild 5: Zielposition

                 Wählen Sie die für Sie bequemste Position der Pedale. Größere Personen
                 sollten die Position so wählen, dass Sie während des Trainings nicht mit den Knien an den Schwingstangen anstoßen.

12           Power.X6.Crosstrainer.Ergometer

ROY_AldS_BDA_PowerX6_Mont_def.in12 12                                                                                                                                                             28.09.2006 9:09:40 Uhr

                                                                                                                             Montage

       9. Stromversorgung und Endkontrolle
            ➞ Vor Anschluß des Adapter-Steckers an das Stromnetz muss das Gerät vollständig auf-
              gebaut sein!                                                                          1             2

     Bild 1: Stecken Sie das eine Ende des Adapters (104) in die Einsteckbuchse auf der Rückseite
     des Gerätes.
     Bild 2: Stecken Sie den Stecker in eine Steckdose.

             Das Gerät sollte nach jedem Gebrauch wieder vom Stromnetz getrennt werden.                  (104)
             Um das Adapterkabel bei Nichtbenutzung oder Bewegen des Gerätes aufzube-
             wahren, wickeln Sie es um den am hinteren Standfuß befindlichen Adapter.

             Achten Sie darauf, das der Adapter während des Betriebes nicht abgedeckt ist.

             Die Netzanschlussleitung des Netzteils kann nicht ersetzt werden. Bei
             Beschädigung der Leitung ist das Netzteil nach Rücksprache mit unserem
             Serviceteam umweltgerecht zu Entsorgen.

             Lassen Sie das unbrauchbare Netzteil ausschließlich von unserem Kundendienst
             durch ein Original-Ersatzteil austauschen.

     Endkontrolle:
     ➞ Um das Gerät zu transportieren, bedienen Sie sich der eingebauten Transportrollen am
       vorderen Standfuß.
     ➞ Kontrollieren Sie nochmals den festen Sitz und den ordnungsgemäßen Zustand aller
       Verbindungen.
     ➞ Damit ist das Gerät zusammengebaut und für den Einsatz bereit.
     ➞ Bevor Sie mit dem Training beginnen, lesen und befolgen Sie die Trainingshinweise auf den
       Seiten 14 und 15.
     ➞ Beachten und befolgen Sie ausnahmslos alle im Kapitel Sicherheitshinweise aufgeführten
       Punkte.

                                                                                                        Power.X6.Crosstrainer.Ergometer          13

ROY_AldS_BDA_PowerX6_Mont_def.in13 13                                                                                               28.09.2006 9:09:41 Uhr

         Trainingshinweise

           Trainingshinweise                                               WICHTIG!                                                            einer mathematischen Formel selbst errechnen. Diese alters-
                                                                           ➞ Regelmäßiges und langfristiges Training.                          bezogene Formel lautet:
                                                                           ➞ Tragen Sie bequeme und luftdurchlässige Kleidung
         Allgemeines:                                                        (z.B. Trainingsanzug).                                             MHF = 220 – Lebensalter
         Grundsätzlich kann jeder gesunde Mensch mit einem Fitness-        ➞ Tragen Sie Schuhe mit rutschfester Gummisohle.                    Es gibt fünf Trainingszonen, die jede einzeln oder alle zusam-
         training beginnen. Bedenken Sie aber, dass lange Versäum-         ➞ Nie barfuß trainieren (Verletzungsgefahr)!                        men eine Rolle für Ihr Training spielen – je nach Ihrem persön-
         nisse sich nicht in kurzer Zeit beseitigen lassen. Körperliche    ➞ Eine Stunde vor und nach dem Training keine Mahlzeiten            lichen Ziel. Die Werte sind im Einzelnen:
         Fitness, Ausdauer und Wohlbefinden lassen sich durch ein            zu sich nehmen.
         entsprechendes Übungsprogramm leicht erreichen. Ihre              ➞ Ausreichend trinken!                                               Gesundheitszone       =   50–60 % der MHF
         Kondition verbessert sich bereits nach relativ kurzem,            ➞ Bei Müdigkeit und Erschöpfung nicht trainieren.                    Fettverbrennung       =   60–70 % der MHF
         regelmäßigen Training und hält damit auch Herz, Kreislauf und     ➞ Mit dem Crosstrainer trainieren Sie neben Ihrer Ausdauer           Aerobe Zone           =   70–80 % der MHF
         Bewegungsapparat in Schwung. Ebenso wird die Sauerstoff-            und Ihrem Herz-Kreislauf-System vor allem Ihre Bein-, Arm-         Anaerobe Zone         =   80–90 % der MHF
         Aufnahmefähigkeit verbessert. Weitere positive Veränderungen        und Oberkörpermuskulatur.                                          Warnzone              =   90–100 % der MHF
         finden im Stoffwechselsystem statt. Wichtig ist, das Training
         dem eigenen Körper anzupassen und sich nicht zu überfordern.      Trainingsplanung:
         Bedenken Sie, Sport soll Spaß machen.                             Ausschlaggebend ist Ihre aktuelle körperliche Leistungs-            Die Gesundheitszone:
                                                                           fähigkeit – besprechen Sie diese vorab mit Ihrem Arzt.              Die Gesundheitszone steht für langsame, lange Ausdauer-
         ACHTUNG!! WIR EMPFEHLEN IHNEN, UNBEDINGT VOR                                                                                          belastung. Die Belastung sollte leicht und entspannt sein.
         TRAININGSBEGINN IHREN ARZT ZU BEFRAGEN.                           Grundsätzlich sollte das Training in drei verschiedene
                                                                           Trainingsphasen gegliedert werden:                                  Diese Zone stellt die Basis für die Steigerung Ihrer Leistungs-
         Trainingsbekleidung:                                              AUFWÄRMEN – TRAINING – ENTSPANNEN
                                                                                                                                               fähigkeit dar, und sollte von Anfängern oder konditionell
                                                                                                                                               schwachen Personen genutzt werden.
         Kopf: Benutzen Sie eventuell ein Stirnband, um das Abtropfen
         des Schweißes zu verhindern.                                      Aufwärmen:                                                          Die Fettverbrennung:
                                                                           Bereitet die Muskeln und den Organismus auf Belastung vor. So       In dieser Zone wird sowohl Ihr Herz gekräftigt, wie auch die
         Oberkörper: Gehen Sie nach dem sogenannten Mehrschich-
                                                                           reduzieren Sie eine eventuelle Verletzungsgefahr. Als Übungen       Fettverbrennung optimal gestaltet, da die verbrauchten Kilojoule
         tensystem vor.
                                                                           bieten sich Aerobic, Dehnübungen und Laufen an. Beginnen Sie        hauptsächlich aus Ihrem Körperfett stammen und weniger aus
         1. Direkt auf der Haut tragen Sie Funktionsunterwäsche, die       das Training grundsätzlich mit dieser Aufwärmphase.                 Kohlehydraten. Zuerst muss sich Ihr Körper an das Training
            den Schweiß von der Haut wegleitet.
                                                                                                                                               gewöhnen – geben Sie sich etwas Zeit. Danach gilt: Je länger
         2. Darüber tragen Sie ein T-Shirt, welches den Schweiß von        Training:                                                           Sie dieses Training durchstehen, desto effektiver wird es.
            der Haut wegleitet. Dieses kann beim Training in warmen        Halten Sie sich an die Empfehlungen für Ihr spezielles Trainings-
            Räumlichkeiten auch weggelassen werden.                        gerät. Die Belastungsintensität kann über die Herzfrequenz          Aerobe Zone:
         Beine: Tragen Sie eine leichte, möglichst anliegende kurze oder   kontrolliert werden. Stimmen Sie sich mit Ihrem Arzt ab.            Mit dem Training in der aeroben Zone verbrennen Sie mehr
         lange Trainingshose. Besonders gut geeignet sind Crane-                                                                               Kohlehydrate als Fett. Durch die höhere Belastung stärken
         Sports-Trainingshosen. Wichtig ist, dass diese im Schritt nicht   Entspannen:                                                         Sie Herz und Lunge. Wenn Sie schneller, stärker und aus-
         reibt, und dass der Gummibund nicht zu eng an der Haut            Der Organismus benötigt während und nach dem Training               dauernder werden möchten, müssen Sie auch in der aeroben
         anliegt, damit die Beindurchblutung nicht beeinträchtigt wird.    Zeit zur Erholung. Bei einem Anfänger soll diese Erholungszeit      Zone trainieren. Der Nutzeffekt dieses Trainings wirkt sich
         Verwenden Sie Sportsocken und keine zu dicken Tennissocken,       länger dauern, als bei einem geübten Sportler.                      enorm auf Ihr Herz und Ihr Atmungssystem aus.
         weil diese die Reibung und damit die Blasenbildung fördern.       FALSCHES ODER ÜBERMÄSSIGES TRAINING KANN ZU
         Ihre Socken sollten keinen zu engen Gummibund haben, damit        GESUNDHEITLICHEN SCHÄDEN FÜHREN!!!!                                 Anaerobe Zone:
                                                                           Eine Methode, um Ihre Trainingsintensität zu bestimmen, ist         Das Training in dieser Zone bringt eine Steigerung der Fähig-
         Ihr Fuß ausreichend durchblutet wird.
                                                                           die maximale Herzfrequenz (MHF). Die MHF können Sie mittels         keit, Milchsäure zu verstoffwechseln. Damit können Sie härter
                                                                                                                                               trainieren, ohne übermäßig Laktat zu bilden. Es ist ein hartes

14           Power.X6.Crosstrainer.Ergometer

ROY_AldS_BDA_PowerX6_Mont_def.in14 14                                                                                                                                                               28.09.2006 9:09:42 Uhr

                              Trainingshinweise / Richtiges Auf- und Absteigen / Crosstrainer Trainingstechnik

     Training, bei dem Sie den typischen Schmerz eines harten
     Trainings verspüren werden, wie z. B. Erschöpfung, schwere        Richtiges Auf- und Absteigen                                   Crosstrainer Trainingstechnik
     Atmung und Müdigkeit. Der Nutzeffekt betrifft vor allem den
     Personenkreis, der an einem Hochleistungstraining interessiert   ➞ Zur Vermeidung von Verletzungen steigen Sie zuerst nur mit   ➞ A) Halten Sie Ihren Oberkörper möglichst aufrecht.
     ist. Wenn Sie nur fit sein wollen, brauchen Sie nie in dieser      einem Bein auf das rechte oder linke Pedal.
                                                                      ➞ Wichtig ist, dass Sie sich mit beiden Händen an dem ovalen   ➞ B) Der Blick ist gerade nach vorne ausgerichtet.
     Zone trainieren.
                                                                        Haltegriff festhalten. Erst nachdem Sie mit beiden Beinen    ➞ C) Die Bewegung sollte hauptsächlich aus den Beinen
     Warnzone:                                                          auf den Pedalen stehen, greifen Sie nach der linken und           heraus kommen.
     Dies ist die Zone mit höchster Intensität und sollte nur mit       rechten Schwingstange.
     großer Vorsicht genutzt werden. Trainieren Sie hier nur, wenn    ➞ Beim Absteigen gehen Sie in umgekehrter Reihenfolge vor:     ➞ D) Die Arme dienen nur der Stabilisierung Ihres Oberkörpers
     Sie extrem fit sind und Erfahrung und praktisches Wissen mit       Hände von den Schwingstangen an den ovalen Haltegriff             (Achtung: Trainieren Sie nie freihändig!)
     extensivem Hochleistungstraining haben. Dieser Bereich kann        wechseln und dort festhalten. Steigen Sie erst danach von    ➞ E) Die Fersen sollten während des Trainings, ähnlich dem
     leicht zu Verletzungen und Überlastung führen. Dies ist ein        den Pedalen ab.                                                   klassischen Langlaufstil, leicht angehoben werden.
     extrem schwieriges Training, das Hochleistungssportlern vor-
     behalten sein sollte. Seitens der Sportmedizin werden folgende         Steigen Sie dabei nicht auf die Kunststoff-              ➞ F) Wechseln Sie ruhig öfters die Griffposition.
     Belastungsumfänge als wirksam erachtet:                                verkleidung des Gerätes.

       HÄUFIGKEIT                DAUER
       Täglich                   10 Minuten                                                                                                                 A
                                                                                                                                                                                         B
       2–3 x wöchentlich         20–30 Minuten
                                                                                                                                                                                         D

                                                                                                                                                                                             F

                                                                                                                                                  C

                                                                                                                                                                        E

                                                                                                                                     Power.X6.Crosstrainer.Ergometer                                      15

ROY_AldS_BDA_PowerX6_Mont_def.in15 15                                                                                                                                                        28.09.2006 9:09:42 Uhr

         Pflege und Wartung / Fehlersuche / Transport / Bewegen

           Pflege und Wartung                                                                                                            Transport / Bewegen des Gerätes
         Wartung:                                                           Pflege:                                                     Bevor Sie das Gerät bewegen, versichern Sie sich, dass Sie
                                                                                                                                        das Gerät ordnungsgemäß vom Stromnetz getrennt haben
         ➞ Grundsätzlich bedarf das Gerät keiner speziellen Wartung.        ➞ Zur Reinigung nur ein feuchtes Tuch ohne scharfe
                                                                                                                                        und das Adapterkabel ordnungsgemäß zur Aufbewahrung um
         ➞ Kontrollieren Sie trotzdem regelmäßig alle Geräteteile und         Reinigungsmittel verwenden.
                                                                                                                                        den Adapter gewickelt ist.
           den festen Sitz aller Schrauben und Verbindungen.                  Achten Sie darauf, dass keine Flüssigkeit in den
         ➞ Tauschen Sie defekte Teile über unseren Kundendienst               Computer eindringt.                                       Fassen Sie das Gerät am ovalen Haltegriff (3). Mit dem linken
           sofort aus – das Gerät darf dann bis zur Instandsetzung                                                                      Fuß fixieren Sie das untere Ende des vorderen Standfußes (31).
           nicht verwendet werden.                                                                                                      Kippen Sie nun das Gerät soweit in Ihre Richtung, bis es mit
                  Vor Durchführung von Pflege- und Wartungarbeiten am Gerät ist das Gerät immer vom Stromnetz zu trennen.               Hilfe der Rollen bewegt werden kann. Achten Sie darauf, dass
                  Versichern Sie sich, dass der Netzstecker des Geräteadapters aus der Stromsteckdose entfernt wurde und                Sie das Gerät nur auf einem ebenen Untergrund bewegen.
                  ordnungsgemäß am Adapterhalter aufbewahrt ist!                                                                        Haben Sie die gewünschte Stelle erreicht, richten Sie das
                                                                                                                                        Gerät wieder vorsichtig auf.

           Fehlersuche
                                                                                                                                               Rollen Sie das Gerät auf Holzböden besonders
          FEHLER                                     URSACHE                                   WAS TUN?                                        vorsichtig, um den Boden mit den Rollen nicht zu
          Computer                                                                                                                             beschädigen!
          Keine Anzeige oder keine Funktion          keine Stromversorgung                     Überprüfen, ob der Adapter richtig
                                                                                               angeschlossen ist
                                                     Keine Kabelverbindung                     Kabelverbindung überprüfen – wenn dies
                                                                                               nicht hilft: Service anrufen               1                                2
          Pulsanzeige bei Handpuls fehlerhaft        nicht beide Hände an beiden Sensoren      Beide Hände gleichzeitig auf beide
                                                                                               Sensoren legen
                                                                                               Kabelverbindung überprüfen
          Pulsanzeige bei Brustgurt fehlerhaft       ungeeigneter Brustgurt                    anderen Brustgurt verwenden
                                                     (Brustgurtbatterie leer)                  Kabelverbindung überprüfen – wenn dies
                                                                                               nicht hilft: Service anrufen
          Mechanik
          Tretwiderstand nicht regelbar              keine Kabelverbindung                     Kabelverbindung überprüfen, wenn dies
                                                                                               nicht hilft: Service anrufen
          Fehlende Teile                                                                       Verpackung überprüfen
                                                                                               Service anrufen
         SONDERFALL COMPUTERABSTURZ:
         Direkte und indirekte statische Entladungen können den Computer des Gerätes zum Absturz bringen.
         Sollte in diesem Falle der Computer nicht wieder von selbst starten, ist ein Neustart des Computers erforderlich.
         Neustart:
         Gerät vom Stromnetz trennen und nach einer Minute wieder verbinden.
         Für technische Auskünfte und Beratung steht Ihnen unser Service-Center zur Verfügung, siehe SERVICE, Seite 17!

16           Power.X6.Crosstrainer.Ergometer

ROY_AldS_BDA_PowerX6_Mont_def.in16 16                                                                                                                                                      28.09.2006 9:09:43 Uhr

                                                                                                                                                              Garantie / Service

       1–2 x wöchentlich         30–60 Minuten                            Nach Ablauf der Garantiezeit haben Sie ebenfalls die Möglichkeit,
       Garantie                                                           das defekte Gerät durch die unten angegebene Adresse                 Widerstandsmessung
     Die Garantiezeit beträgt 36 Monate und beginnt mit dem Tag des
                                                                          reparieren zu lassen. Anfallende Reparaturen nach Ablauf der
                                                                          Garantiezeit inklusive dem Versand sind kostenpflichtig.
                                                                                                                                               (Watt-Messung)
     Kaufs. Bitte bewahren Sie den Kassenbon als Nachweis für den         Ihre gesetzlichen Rechte werden durch diese Garantie nicht
     Kauf auf.                                                                                                                                Der Tretwiderstand (Watt) wird durch ein elektronisch er-
                                                                          eingeschränkt.
                                                                                                                                              zeugtes Magnetfeld (Feldspulenprinzip) generiert. Das tech-
     Es gelten folgende Garantiebestimmungen:                                                                                                 nisch hochwertigste Bremssystem auf dem Markt zeichnet
     Der Hersteller garantiert die kostenfreie Behebung von Mängeln,
     die auf Material- oder Fabrikationsfehler zurückzuführen sind.        Service + Hotline                                                  sich durch eine schnelle und genaue Belastungssteuerung,
                                                                                                                                              seine hohe Anzeigegenauigkeit, sehr gelenksschonende
     Bei Feststellung eines Mangels sind Sie verpflichtet, diesen         Sollten Sie weitergehende Fragen haben oder mit dem Zusam-          Rundlaufeigenschaft und hohe maximale Tretwiderstands-
     unverzüglich dem RC Sportgeräte Service zu melden. Schäden           menbau irgendwelche Schwierigkeiten haben, so rufen Sie uns         leistung (Watt) aus. Diese besonderen Eigenschaften der
     infolge unsachgemäßer Handhabung, Nichtbeachtung der                 unter unserer Servicehotline kurz an.                               Wirbelstrombremse im Zusammenspiel mit dem hochwertigen
     Bedienungsanleitung, unsachgemäßer Montage, unzureichen-             Wir können Ihnen sicher weiterhelfen.                               Trainingscomputer und der ergonomischen Konstruktion des
     der Pflege, Gewaltanwendung oder normaler Abnutzung fallen           Sollte mit dem Gerät etwas nicht in Ordnung sein, wird es           Gerätes garantieren ein noch effizienteres, komfortableres und
     nicht unter diese Garantie.                                          während der Garantiezeit kostenfrei Vorort repariert oder Sie       benutzerfreundlicheres Ergometer-Training.
     Verschleißteile wie Keilriemen, Lager, Griffe sind von der           erhalten ein neues Gerät retour. Bitte beachten Sie, dass bei
     Garantie und Gewährleistung ausgeschlossen.                          der Abholung das komplette Gerät (es dürfen keine Teile aus         Durchführung der Wattmessung:
                                                                          dem Lieferumfang fehlen) an den Spediteur übergeben werden
     Der Hersteller haftet nicht für ursächliche Schäden oder             muss. Aus Transportgründen und zum Schutz der Ware kön-              Drehzahl bei                Zu überprüfende
     Folgeschäden jedweder Art, es sei denn, dass eine derar-             nen nur unaufgebaute Geräte an den Kunden zugestellt wer-            der Prüfung:                Einstellungen:
     tige Haftungsbegrenzung vom Gesetzgeber ausdrücklich                 den. Das gilt auch für reparierte oder neue Geräte. Beachten         50 U / min.                 50 W und 100 W
     untersagt ist. Es steht im Ermessen des Herstellers, die             Sie bitte auch, dass aus Gewichtsgründen eine Rücksendung            60 U / min.                 150 W, 200 W und 250 W
     Garantie durch Reparatur oder Ersatzlieferung zu erfüllen.           per Post nicht möglich ist.                                          70 U / min.                 300 W, 350 W und 400 W
     Weitergehende Ansprüche bestehen nicht. Bei nicht berech-            Um Ihnen Unannehmlichkeiten zu ersparen, rufen Sie uns
     tigter Garantieeinsendung behält sich der Hersteller vor, die        vorher an. Wir beraten Sie gerne.
     Rücksendung unfrei vorzunehmen. Während der Garantiezeit
     besteht für defekte Crosstrainer von u.a. Serviceadresse ein         Für technische Auskünfte und Beratung steht Ihnen unsere
     kostenloser Vorort-Service. Ist eine Reparatur Vorort nicht          Service-Hotline von Montag bis Freitag in der Zeit von 8.00 bis
                                                                          17.00 Uhr zur Verfügung:
     möglich erhalten Sie ein repariertes, unaufgebautes Gerät
     kostenlos zurück. Ein Anspruch auf eine Gerätemontage kann           RC Sportgeräte Service
     nicht abgeleitet werden. Bitte beachten Sie, dass im Falle einer     Telefon: 0800 / 020 30 45
     Rücksendung nur das komplette Gerät (es dürfen keine Teile           E-Mail: service@rc-sportgeraete.de
     aus dem Verpackungs-Lieferumfang fehlen) an den Spediteur
                                                                          Bei etwaiger Rückgabe bitte das komplette Zubehör, die
     übergeben werden kann. Da aus Gewichtsgründen eine
                                                                          Montage-, Bedienungs- und Trainingsanleitung, die Computer-
     Rücksendung per Post vielleicht nicht möglich ist, setzen Sie
                                                                          Bedienungsanleitung, die vollständig ausgefüllte Garantiekarte,
     sich für technische Auskünfte und Beratung zunächst mit
                                                                          die Originalverpackung und eine Kopie des Kassabeleges
     unserem Serviceteam in Verbindung. Um die Ware im Falle
                                                                          nicht vergessen.
     einer Reparatur oder Retoursendung ausreichend zu schüt-
     zen, bitten wir Sie, falls möglich, die Originalverpackung für die   Hotline Trainingsplanungs- und
     Dauer der Garantiezeit aufzubewahren.                                Trainingsauswertungs-Software:
                                                                          ➞ Telefon: 0180 / 50 20 307 (! 0,12 / Min.)
     Bitte kontaktieren Sie in jedem Fall unbedingt vorab unseren         ➞ E-Mail: service@rc-sportgeraete.de
     Kundendienst.

                                                                                                                                              Power.X6.Crosstrainer.Ergometer                                     17

ROY_AldS_BDA_PowerX6_Mont_def.in17 17                                                                                                                                                                28.09.2006 9:09:43 Uhr

         Explosionszeichnung

                                                                 119
                                               111

                                                                             115
                                               112
                                                                                   64

                                                                                             114
                                                                       113

                                                           116

                                                                 117

                                        115

                                                     108

                              118

                                                                                        32

18           Power.X6.Crosstrainer.Ergometer

ROY_AldS_BDA_PowerX6_Mont_def.in18 18                                                              28.09.2006 9:09:44 Uhr

                                                                                                                                                    Ersatzteileliste

     Nr. Bezeichnung                                     Anzahl   Nr. Bezeichnung                                   Anzahl   Nr. Bezeichnung                                  Anzahl
        1 Computer                                           1     41 Kugellager (6000Z)                                 6    81 Schraube (M10 x 30)                                 2
        2 Schwingstange, links                               1     42 Sechskantschraube (M10 x 100)                      2    82 Schraube (M4 x 15)                                  4
        3 ovaler Haltegriff                                  1     43 Bolzen/Achse Schwingscheibe                        1    83 Distanzhülse (Ø 16 x Ø 10,2)                        2
        4 Schwingstangenverkleidung, links                   1     44 Mutter, Nylon (M10)                                2    84 Dichtung für Hauptrahmen                            1
        5 Verkleidung ovaler Haltegriff                      1     45 Schraube (M8 x 30) für Haltegriff                  2    85 Mutter, Nylon (M10)                                 3
        6 Schraube zur Abdeckscheibenfixierung                     46 Pendelkugellager                                   2    86 Unterlegscheibe zur Pedalstangenmontage
          und Computermontage (M5 x 15)                      25    47 Abdeckkappe für Abdeckscheibe (Ø 70)               2       (Ø 20 x Ø 10,2 x 2)                                 4
        7 Schraube (M8 x 20)                                  8    48 Abdeckscheibe (Ø 380)                              2    87 Kreuzschlitzschraube zur Pedalstangenmontage
        8 Unterlegscheibe gewellt (Ø15,5)                     2    49 Kreuzstange, links                                 1       (M5 x 20)                                           8
        9 Abstandhalter für Schwingstange                     2    50 Tretlagerachse                                     1    88 Unterlegscheibe (Ø 32 x Ø 17)                       1
       10 Lenkersäule                                         1    51 Schraube für Achse (M8 x 15)                       3    89 Computerkabel, oben                                 1
       11 Unterlegscheibe (Ø25)                               2    52 Keilriemenrad (Ø 280)                              1    90 Computerkabel, unten                                1
       12 Federring M8                                       15    53 Keilriemen (1168.J6)                               1    91 Steuerplatine für Wirbelstrombremse                 1
       13 Unterlegscheibe, gebogen (Ø19)                      2    54 Magnet mit Fixierung                               1    92 Sensor mit Kabeln (700 mm)                          1
       14 Trinkflasche                                        1    55 Unterlegscheibe                                    2    93 Handpulskabel, Lenkersäule                          1
       15 Trinkflaschenhalter                                 1    56 C-Ring (Ø 16)                                      2    94 Handpulskabel, Schwingarm                           2
       16 C-Ring (Ø35)                                        2    57 Kugellager (6003Z)                                 2    95 Handpulssensoren                                    2
       17 Kreuzschlitzschraube (M4 x 25)                      6    58 Schrauben                                          4    96 Kunststoffbuchse                                    2
       18 Schnellverstellschraube (M16)                       2    59 Schaum                                             8    97 Steckerhalter                                       2
       19 Schwingstange, unterer Teil                         2    60 Schwingscheiben-Set mit Bremssystem                1    98 Abdeckung für Transportrollen                       2
       20 Pedalstange, links                                  1    61 Anschlußbuchse und Kabel für Adapter               1    99 Achse der Transportrollen                           2
       21 Pedal, links                                        1    62 Kabelbinder                                        1   100 Transportrolle (Ø 50)                               2
       22 Schlossschraube (M8)                                4    63 C-Ring Ø 40                                        2   101 Mutter, Nylon (M10)                                 2
       23 Rändelmutter für Pedal (M8 x Ø50)                   4    64 Kettenkasten, rechts                               1   102 Kreuzschlitzschraube für Handpulssensor (M4 x 15)   4
       24 Kunststoffbuchse                                    2    65 Verkleidung vorne,links                            1   103 Gewindebuchse M5                                    2
       25 Hauptrahmen                                         1    66 Endkappe für Schwingstange                         2   104 Adapter
       26 Standfuß, hinten                                    1    67 Computerhals                                       1   105 Kunststoffabdeckung für Lenkersäule                 1
       27 Abdeckkappe Standfuß                                4    68 Schraube für Verkleidung (M5 x 15)                11   106 Standfußplatte aus Gummi                            4
       28 Schraube Standfuß (M10 x 25)                        4    69 Kreuzschlitzschraube für Kettenkasten (M5 x 25)   10   107 Schraube zur Pedalstangenfixierung                  2
       29 Federring M10                                       4    70 Unterlegscheibe (Ø22 x Ø8,4)                       2   108 Unterlegscheibe, gewellt (Ø17,5)                    1
       30 Unterlegscheibe (Ø25 x Ø10,5)                       4    71 Schraube für Fixierung der Standfußabdeckung           111 Schwingstange rechts                                1
       31 Standfuß, vorne                                     1       (M5 x25)                                          20   112 Schwingstangenverkleidung, rechts                   1
       32 Schraubenzieher                                     1    72 Sechskantschraube Kreuzstangen                     2   113 Pedalstange, rechts                                 1
       33 Universalschlüssel                                  1    73 Abdeckkappe                                        4   114 Pedal, rechts                                       1
       34 Steckschlüssel                                      1    74 Unterlegscheibe (Ø19 x Ø8,4 x 2,0)                 2   115 Verkleidung Pedalstange, jeweils rechts             2
       35 Schaumstoffüberzug                                  1    75 Kreuzschlitzschraube (M5 x 12)                     2   116 Verkleidung Schwingstange unterer Teil rechts       2
       36 Schaumstoffüberzug                                  2    76 Unterlegscheibe für Lenkersäule (Ø19 x Ø8,4)       4   117 Kreuzstange, rechts                                 1
       37 Kugellager für Schwingstange (6002Z)                4    77 Schaumstoff                                        2   118 Kettenkasten, links                                 1
       38 Hülse für Ansatzrohr                                2    78 Halteschiene für Keilriemen-Rollen                 1   119 Verkleidung vorne, rechts                           1
       39 Verkleidung Pedalstange, jeweils links              2    79 Spannfeder                                         1
       40 Verkleidung Schwingstange unterer Teil links        2    80 Keilriemen-Laufrolle                               2

                                                                                                                             Power.X6.Crosstrainer.Ergometer                                  19

ROY_AldS_BDA_PowerX6_Mont_def.in19 19                                                                                                                                            28.09.2006 9:09:44 Uhr

                                                   5/2006
ROY_AldS_BDA_PowerX6_Mont_def.in20 20   28.09.2006 9:09:04 Uhr
