jluehr-4711/tmp_crane/docs/img/manual-p08-column-cable.png

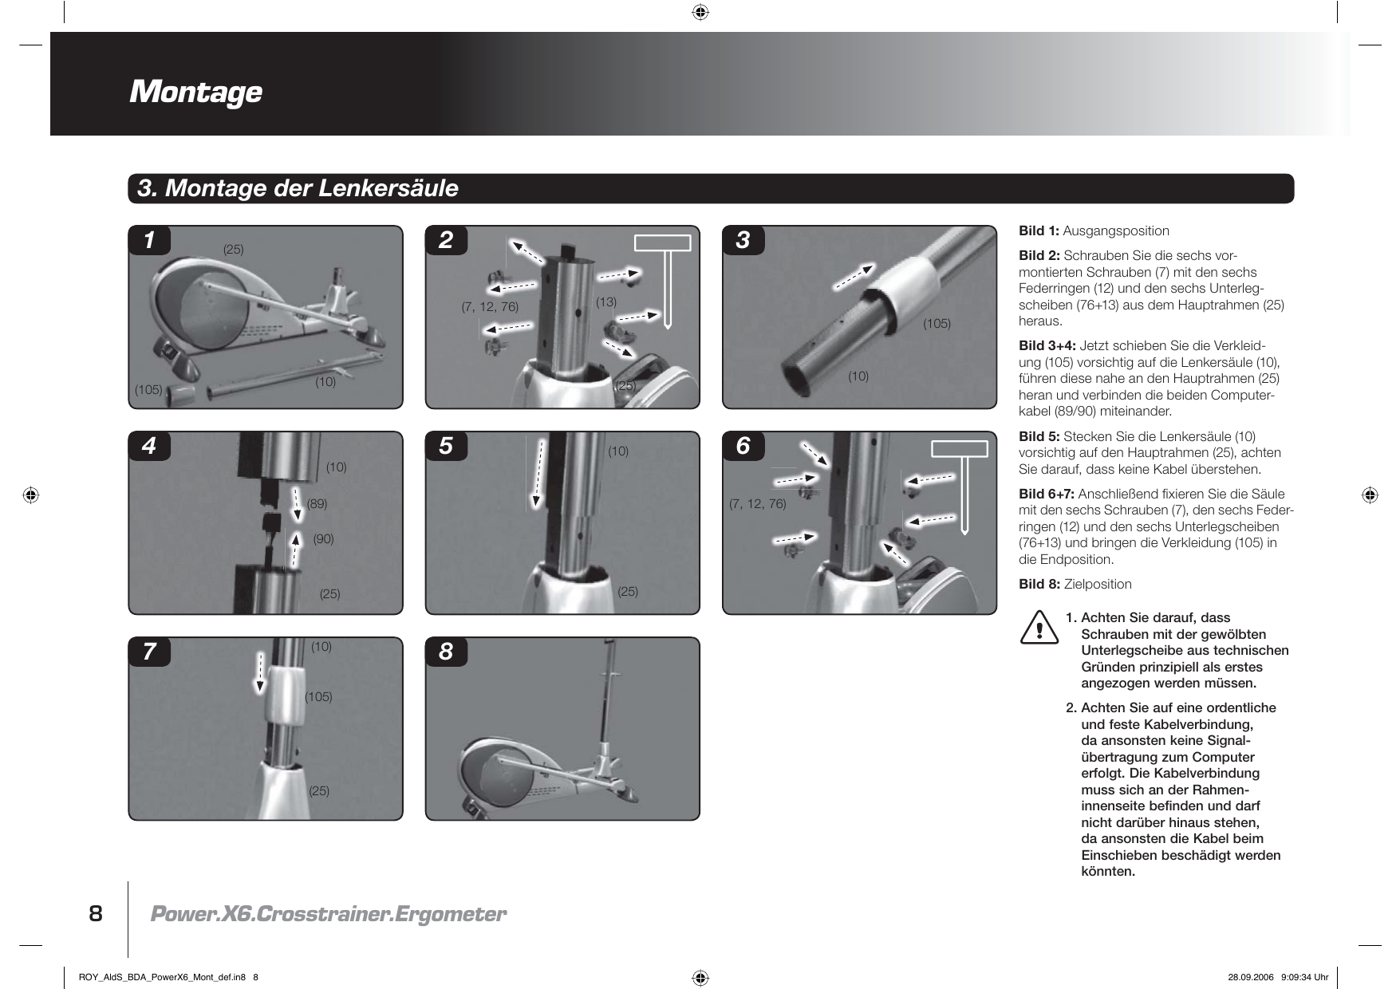
docs/img/manual-p08-column-cable.png
