jluehr-4711/tmp_crane/docs/img/manual-p09-console-mounting.png

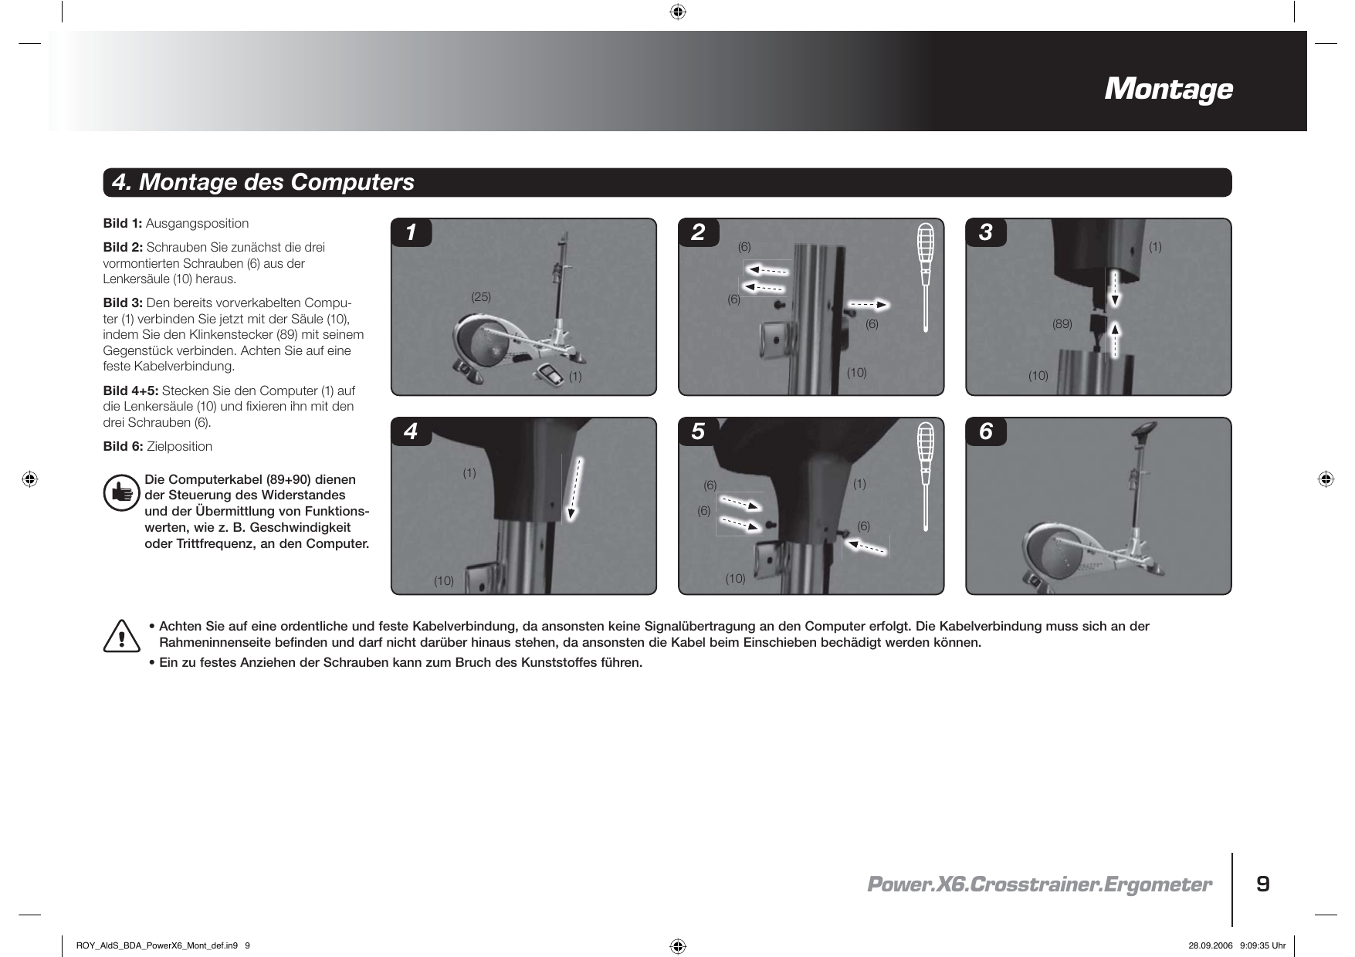
docs/img/manual-p09-console-mounting.png
