jluehr-4711/tmp_crane/docs/img/manual-p18-exploded-view.png

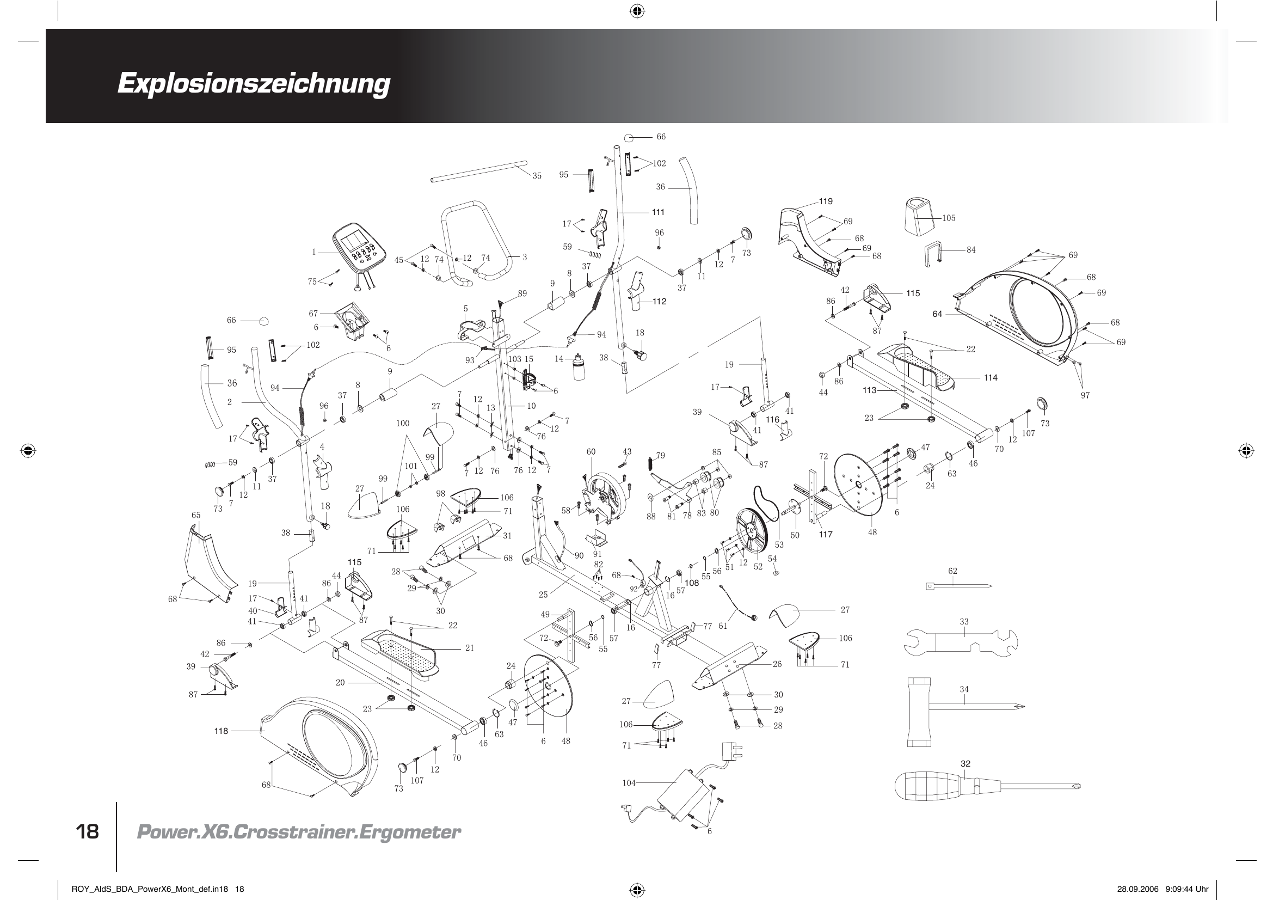
docs/img/manual-p18-exploded-view.png
