jluehr-4711/tmp_crane/hardware/kicad/adapter.kicad_sch

## KiCad design hardware/kicad/adapter.kicad_sch (2026-10-26)

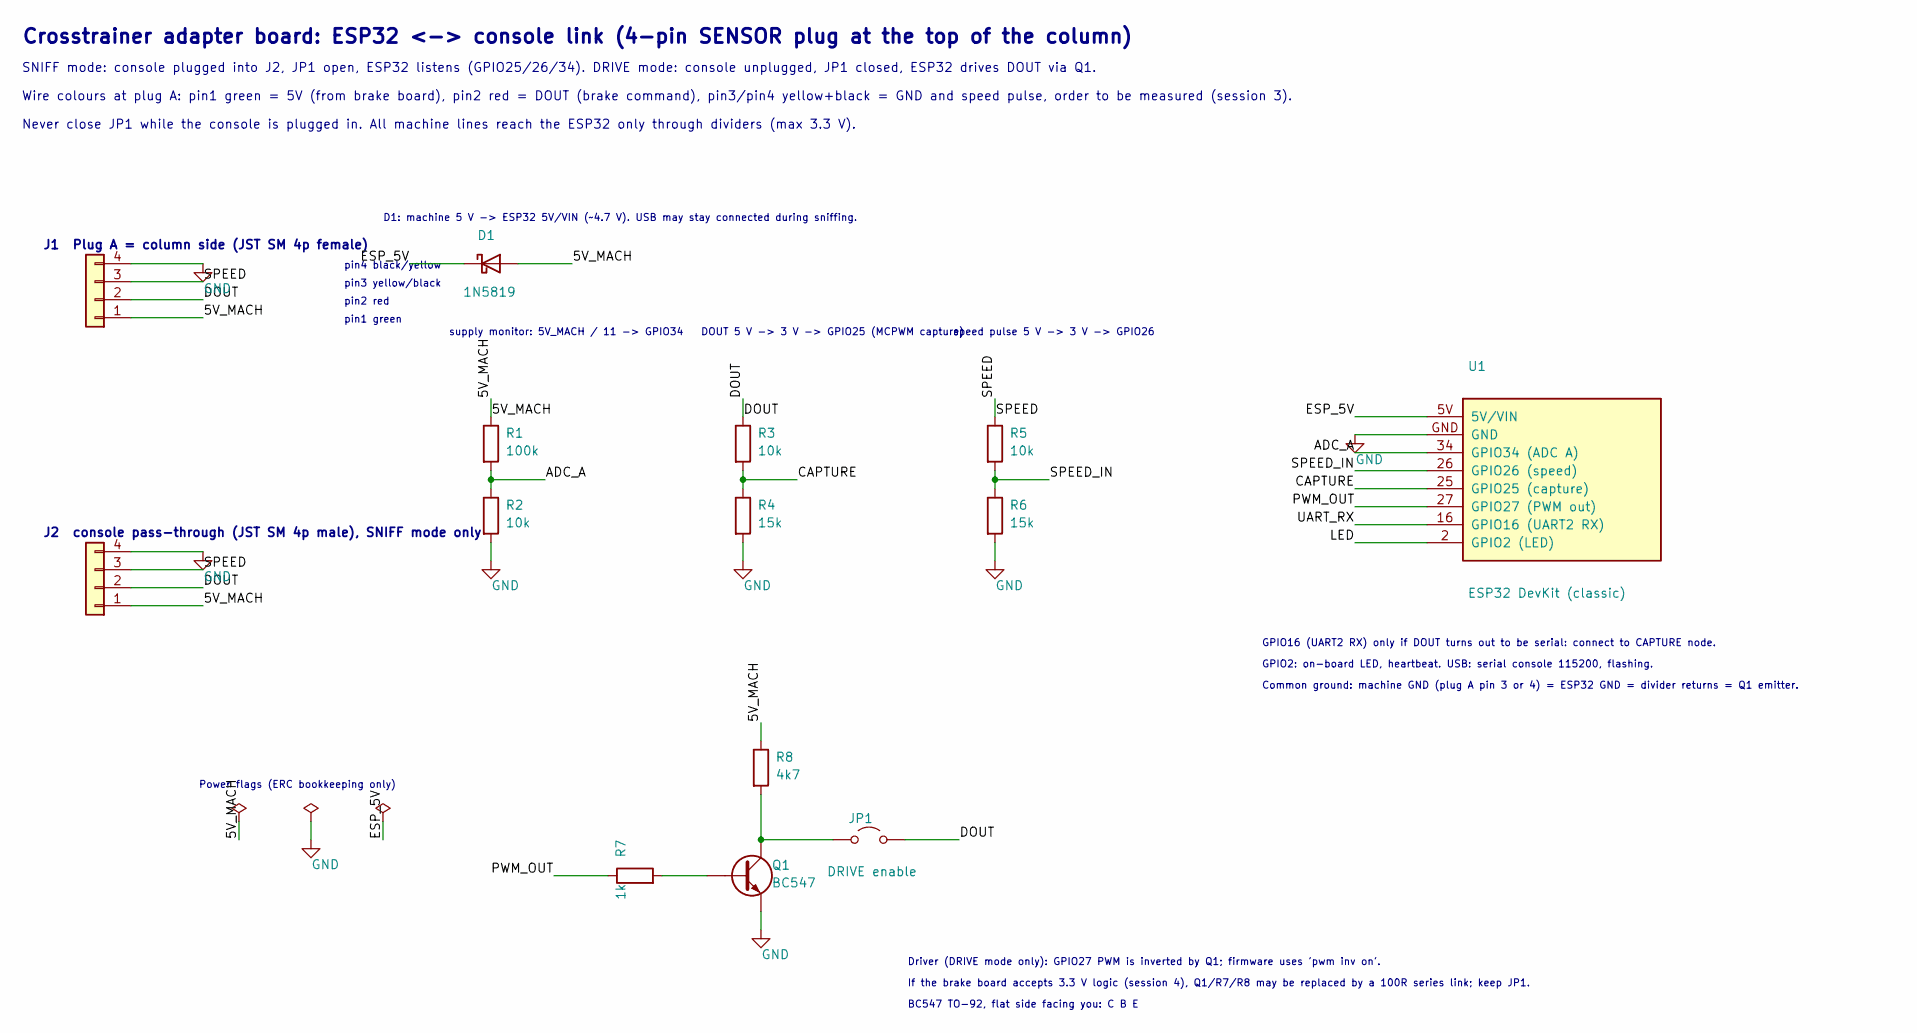
[picture p17: schematic adapter.kicad_sch]

Parts:
D1: 1N5819
J1: Plug A
J2: Pass-through
JP1: DRIVE enable
Q1: BC547
R1: 100k
R2, R3, R5: 10k
R4, R6: 15k
R7: 1k
R8: 4k7
U1: ESP32 DevKit (classic)

Connections:
5V_MACH: D1.2 (A), J1.1, J2.1, R1.1, R8.1
ADC_A: R1.2, R2.1, U1.34 (GPIO34 (ADC A))
CAPTURE: R3.2, R4.1, U1.25 (GPIO25 (capture))
DOUT: J1.2, J2.2, JP1.2 (B), R3.1
ESP_5V: D1.1 (K), U1.5V (5V/VIN)
GND: J1.4, J2.4, Q1.E, R2.2, R4.2, R6.2, U1.GND
LED: U1.2 (GPIO2 (LED))
unnamed: JP1.1 (A), Q1.C, R8.2
unnamed: Q1.B, R7.2
PWM_OUT: R7.1, U1.27 (GPIO27 (PWM out))
SPEED: J1.3, J2.3, R5.1
SPEED_IN: R5.2, R6.1, U1.26 (GPIO26 (speed))
UART_RX: U1.16 (GPIO16 (UART2 RX))

Notes on the sheet:
Crosstrainer adapter board: ESP32 <-> console link (4-pin SENSOR plug at the top of the column)
SNIFF mode: console plugged into J2, JP1 open, ESP32 listens (GPIO25/26/34). DRIVE mode: console unplugged, JP1 closed, ESP32 drives DOUT via Q1.
Wire colours at plug A: pin1 green = 5V (from brake board), pin2 red = DOUT (brake command), pin3/pin4 yellow+black = GND and speed pulse, order to be measured (session 3).
Never close JP1 while the console is plugged in. All machine lines reach the ESP32 only through dividers (max 3.3 V).
J1 Plug A = column side (JST SM 4p female)
J2 console pass-through (JST SM 4p male), SNIFF mode only
pin1 green
pin2 red
pin3 yellow/black
pin4 black/yellow
D1: machine 5 V -> ESP32 5V/VIN (~4.7 V). USB may stay connected during sniffing.
supply monitor: 5V_MACH / 11 -> GPIO34
DOUT 5 V -> 3 V -> GPIO25 (MCPWM capture)
speed pulse 5 V -> 3 V -> GPIO26
Driver (DRIVE mode only): GPIO27 PWM is inverted by Q1; firmware uses 'pwm inv on'.
If the brake board accepts 3.3 V logic (session 4), Q1/R7/R8 may be replaced by a 100R series link; keep JP1.
BC547 TO-92, flat side facing you: C B E
GPIO16 (UART2 RX) only if DOUT turns out to be serial: connect to CAPTURE node.
GPIO2: on-board LED, heartbeat. USB: serial console 115200, flashing.
Common ground: machine GND (plug A pin 3 or 4) = ESP32 GND = divider returns = Q1 emitter.
Power flags (ERC bookkeeping only)
