jluehr-4711/tmp_crane/(commit log)

2026-10-26 Project init: docs structure, material review, interview results
    - docs/: overview, material inventory, hardware reference, plan, open questions, photo guide, session 01 log
    - material/: manual, console/adapter photos (incl. IMG_0629/0630 from /tmp/r2)
    - CLAUDE.md: rules cleaned up, decisions recorded
2026-10-26 Session 02: CLAUDE.md decisions, sniffer firmware, docs
    - firmware/sniffer: ESP-IDF 5.5 project for the classic ESP32 (ADC probes,
    MCPWM capture of DOUT, speed pulse timing, UART sniff, PWM replay output,
    serial console); builds clean
    - docs/07-sniffer.md: pin map, dividers, parts list, procedure
    - docs/sessions/2026-10-26-session-02.md, plan and README updated
2026-10-26 docs: unified adapter board (sniff + final), safe multimeter procedure
2026-10-26 sniffer: 'pwm inv on|off' for the inverting transistor stage
    [console_cmds.c, pwm_out.c, sniffer.h]
2026-10-26 docs: single-order option (Amazon.de) in the shopping list
2026-10-26 hardware: KiCad schematic of the adapter board (generated, ERC-clean); replaces hand-drawn sketch
    [adapter.kicad_sch]
2026-10-26 hardware: perfboard layout (net-validated) with Dupont header to the ESP32
